jmohos/Wiper_Motor_Servo/Hardware/Kicad/Wiper_Servo_Controller/JLCPCB/invoice.pdf

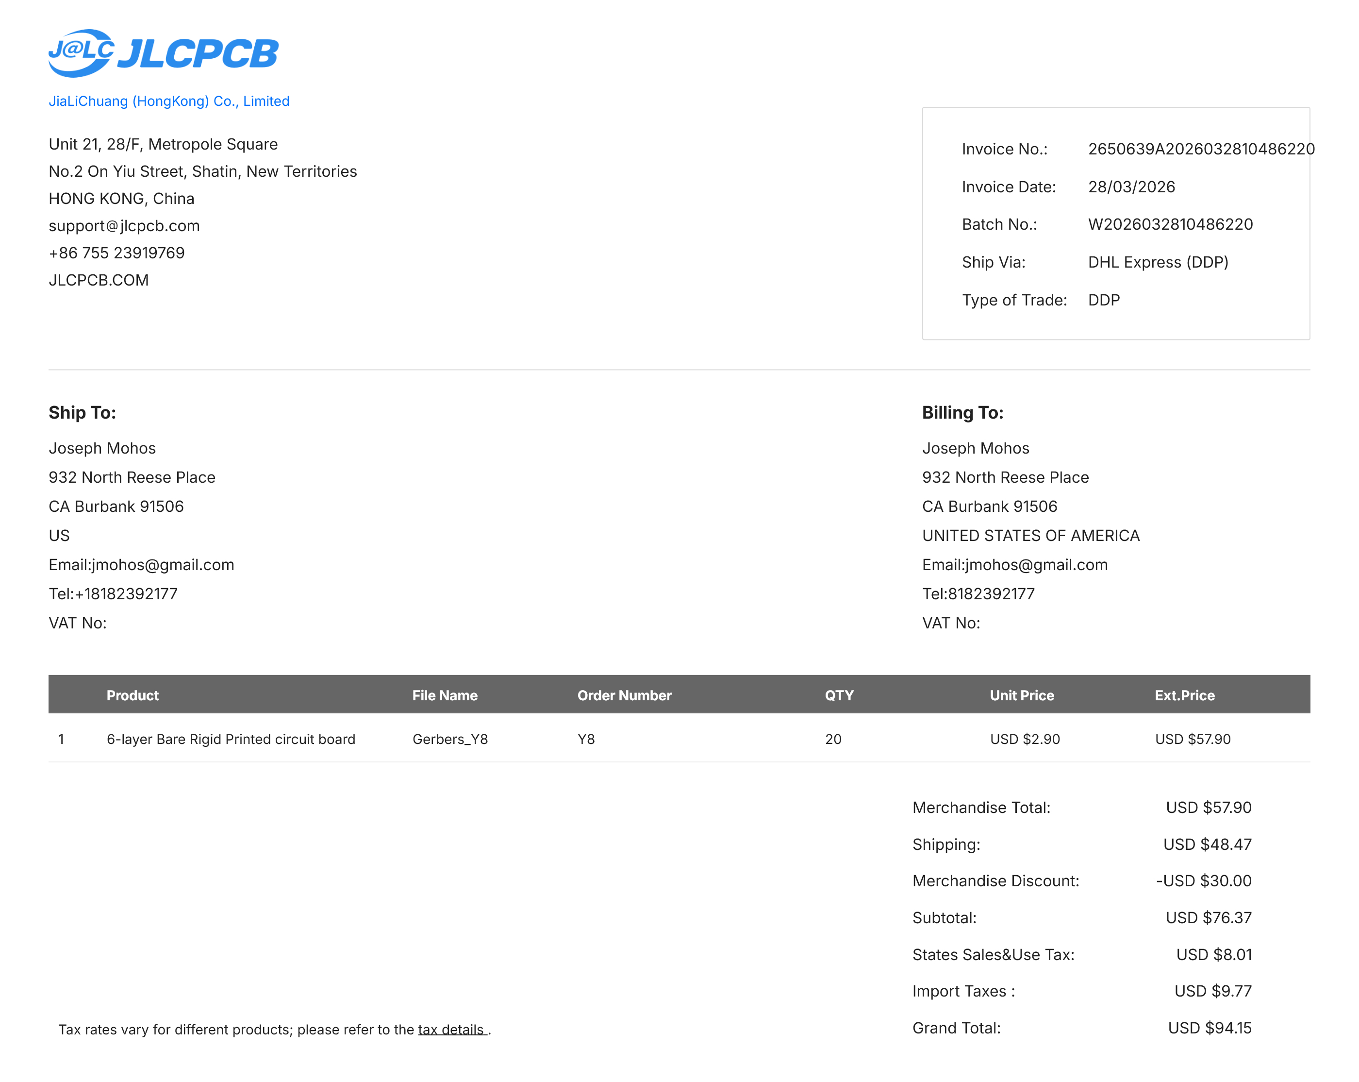
[picture p1: figure]
