jmohos/Wiper_Motor_Servo/Hardware/3D_Models/Display_Mount.stl

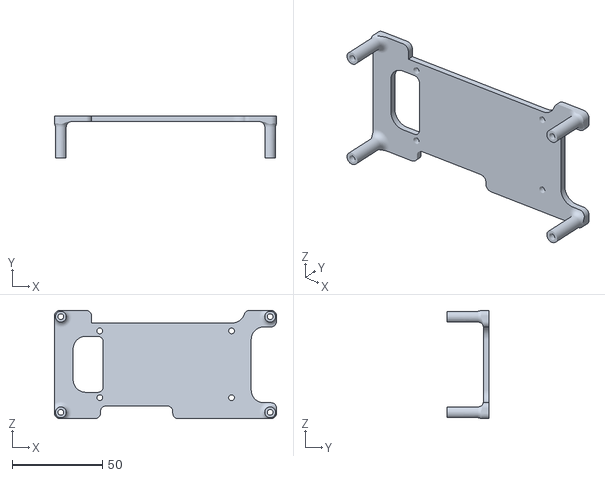
[picture p2: CAD file, 2026-04-15]
Hardware/3D_Models/Display_Mount.stl
123.0 x 23.0 x 60.0
