jmohos/Wiper_Motor_Servo/Hardware/Kicad/Wiper_Servo_Controller/RFB-0505S/RFB-0505S.step

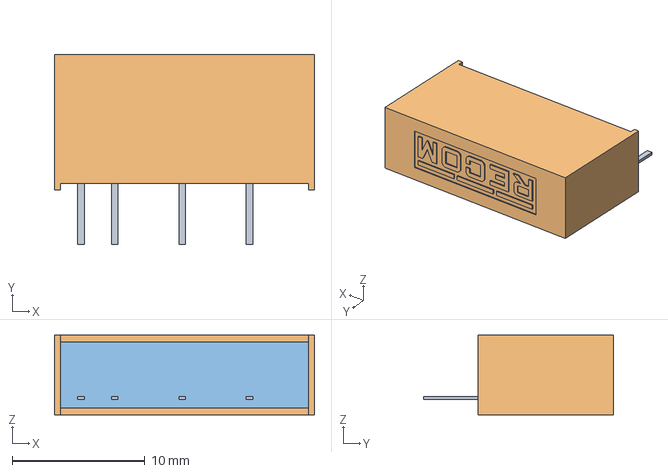
[picture p3: CAD file, 2026-03-24]
Hardware/Kicad/Wiper_Servo_Controller/RFB-0505S/RFB-0505S.step
19.6 x 14.3 x 6.00 mm
