jmohos/Wiper_Motor_Servo/Hardware/Kicad/Wiper_Servo_Controller/Wiper_Servo_Controller.step

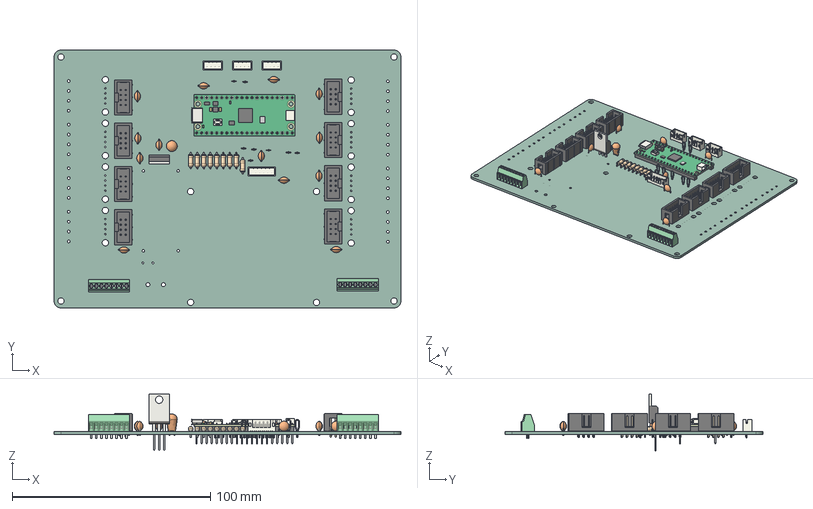
[picture p4: CAD file, 2026-04-01]
Hardware/Kicad/Wiper_Servo_Controller/Wiper_Servo_Controller.step
175.0 x 130.0 x 28.5 mm
R_Axial_DIN0207_L6.3mm_D2.5mm_P7.62mm_Horizontal x 9
TestPoint_Loop_D2.50mm_Drill1.0mm x 8
IDC-Header_2x04_P2.54mm_Vertical x 8
C_Disc_D5.1mm_W3.2mm_P5.00mm x 13
JST_PH_B4B-PH-K_1x04_P2.00mm_Vertical x 3
TerminalBlock_Phoenix_MPT-0,5-8-2.54_1x08_P2.54mm_Horizontal x 2
JST_PH_B6B-PH-K_1x06_P2.00mm_Vertical
TO-220-3_Vertical
CP_Radial_Tantal_D5.5mm_P2.50mm
RaspberryPi_Pico_H_Module_KiCad
RaspberryPi_Pico_Header_DIP-40_H2.54mm_KiCad
Wiper_Servo_Controller_PCB
