jmohos/Wiper_Motor_Servo/Hardware/3D_Models/Quad_Controller_Lower_Plate.stl

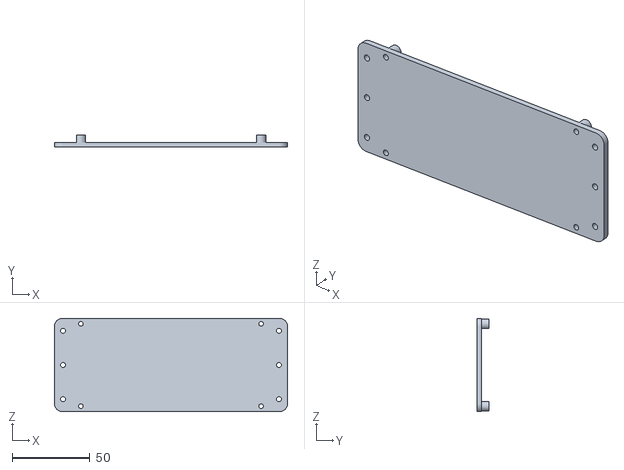
[picture p5: CAD file, 2026-04-15]
Hardware/3D_Models/Quad_Controller_Lower_Plate.stl
150.0 x 8.00 x 60.0
