jmohos/Wiper_Motor_Servo/Hardware/3D_Models/Magnet_Mount.stl

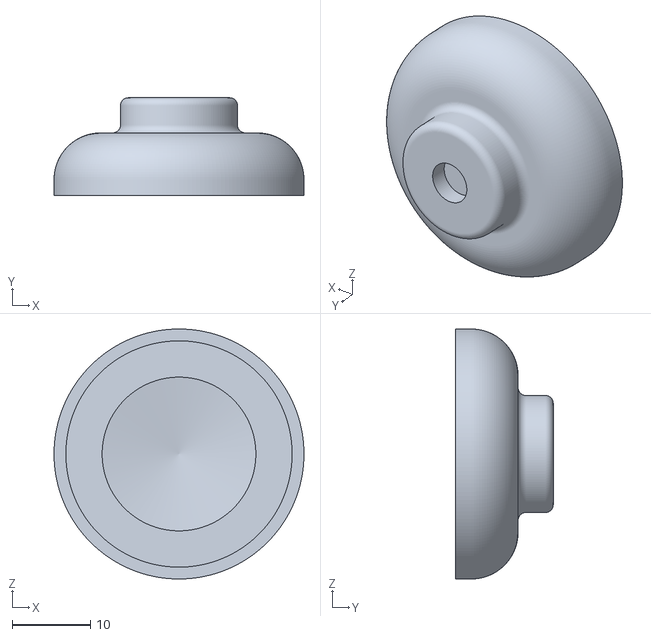
[picture p6: CAD file, 2026-03-24]
Hardware/3D_Models/Magnet_Mount.stl
32.0 x 12.5 x 32.0
