jmohos/Wiper_Motor_Servo/Hardware/3D_Models/Encoder_Cap.stl

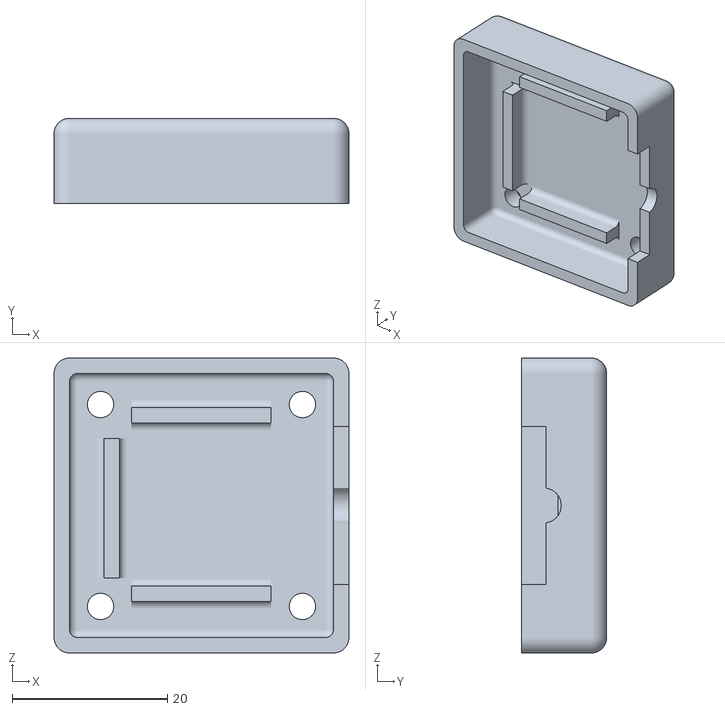
[picture p7: CAD file, 2026-03-24]
Hardware/3D_Models/Encoder_Cap.stl
38.0 x 11.0 x 38.0
