jmohos/Wiper_Motor_Servo/Hardware/3D_Models/Encoder_Plate.stl

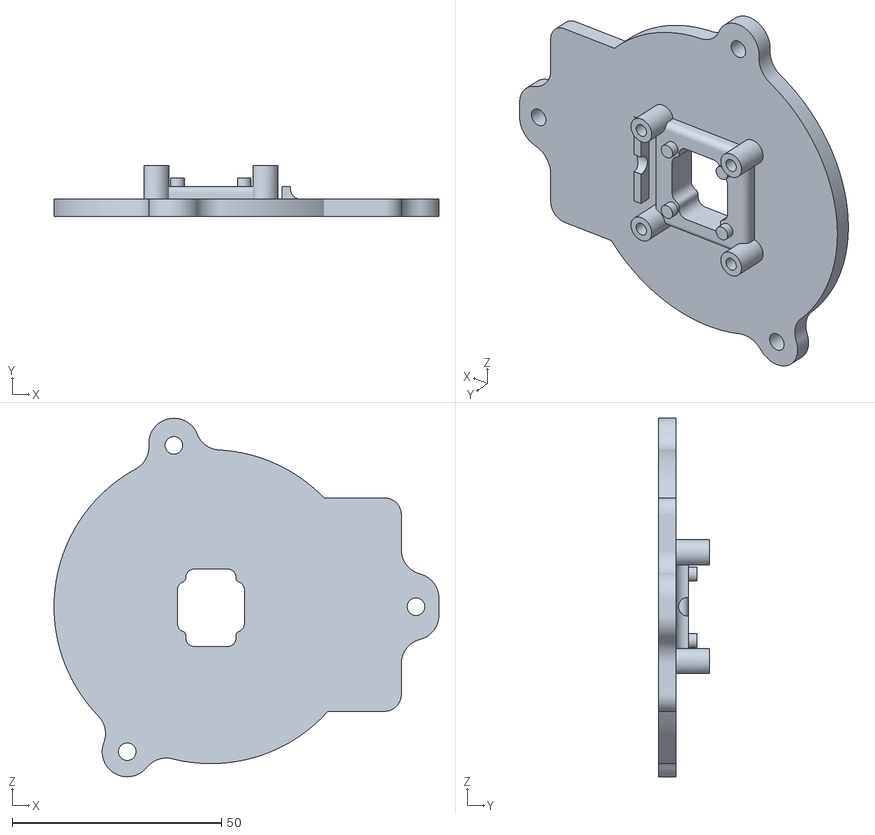
[picture p8: CAD file, 2026-03-24]
Hardware/3D_Models/Encoder_Plate.stl
92.0 x 12.1 x 85.7
