jmohos/Wiper_Motor_Servo/Hardware/Kicad/Wiper_Servo_Controller/Wiper_Servo_Controller.pdf

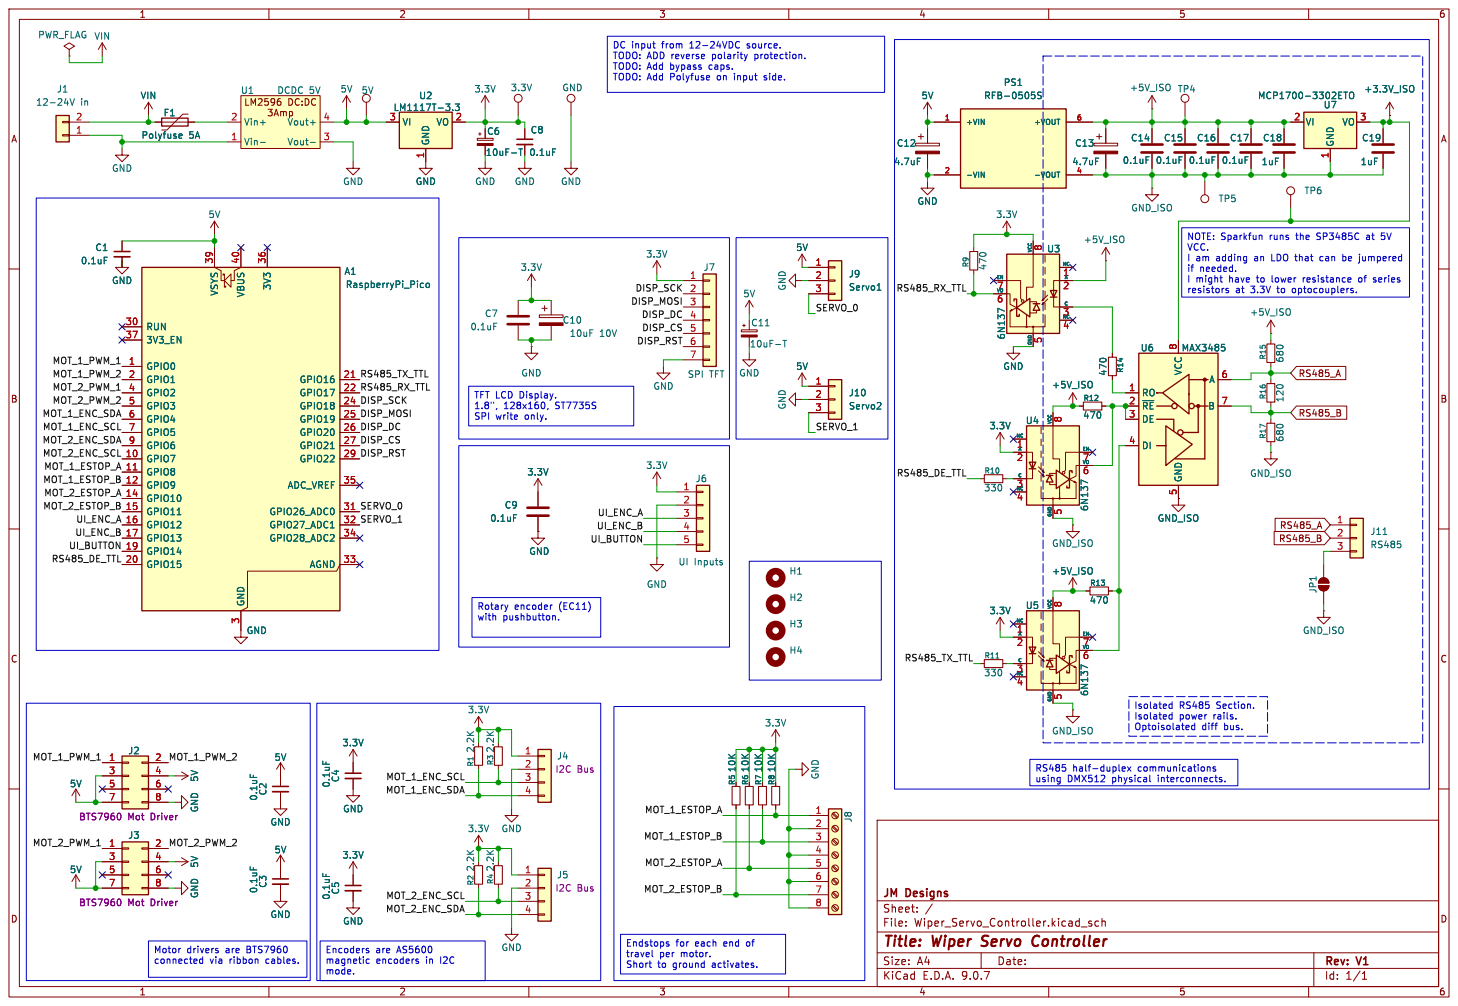
[picture p9: page 1]

VCC.
I am adding an LDO that can be jumpered
if needed.

SPI write only. Motor drivers are BTS7960

travel per motor. Short to ground activates.
