jmohos/Wiper_Motor_Servo/Hardware/Kicad/Wiper_Servo_Controller/Wiper_Servo_Controller.kicad_pcb

## KiCad design Hardware/Kicad/Wiper_Servo_Controller/Wiper_Servo_Controller.kicad_pcb (2026-04-01)

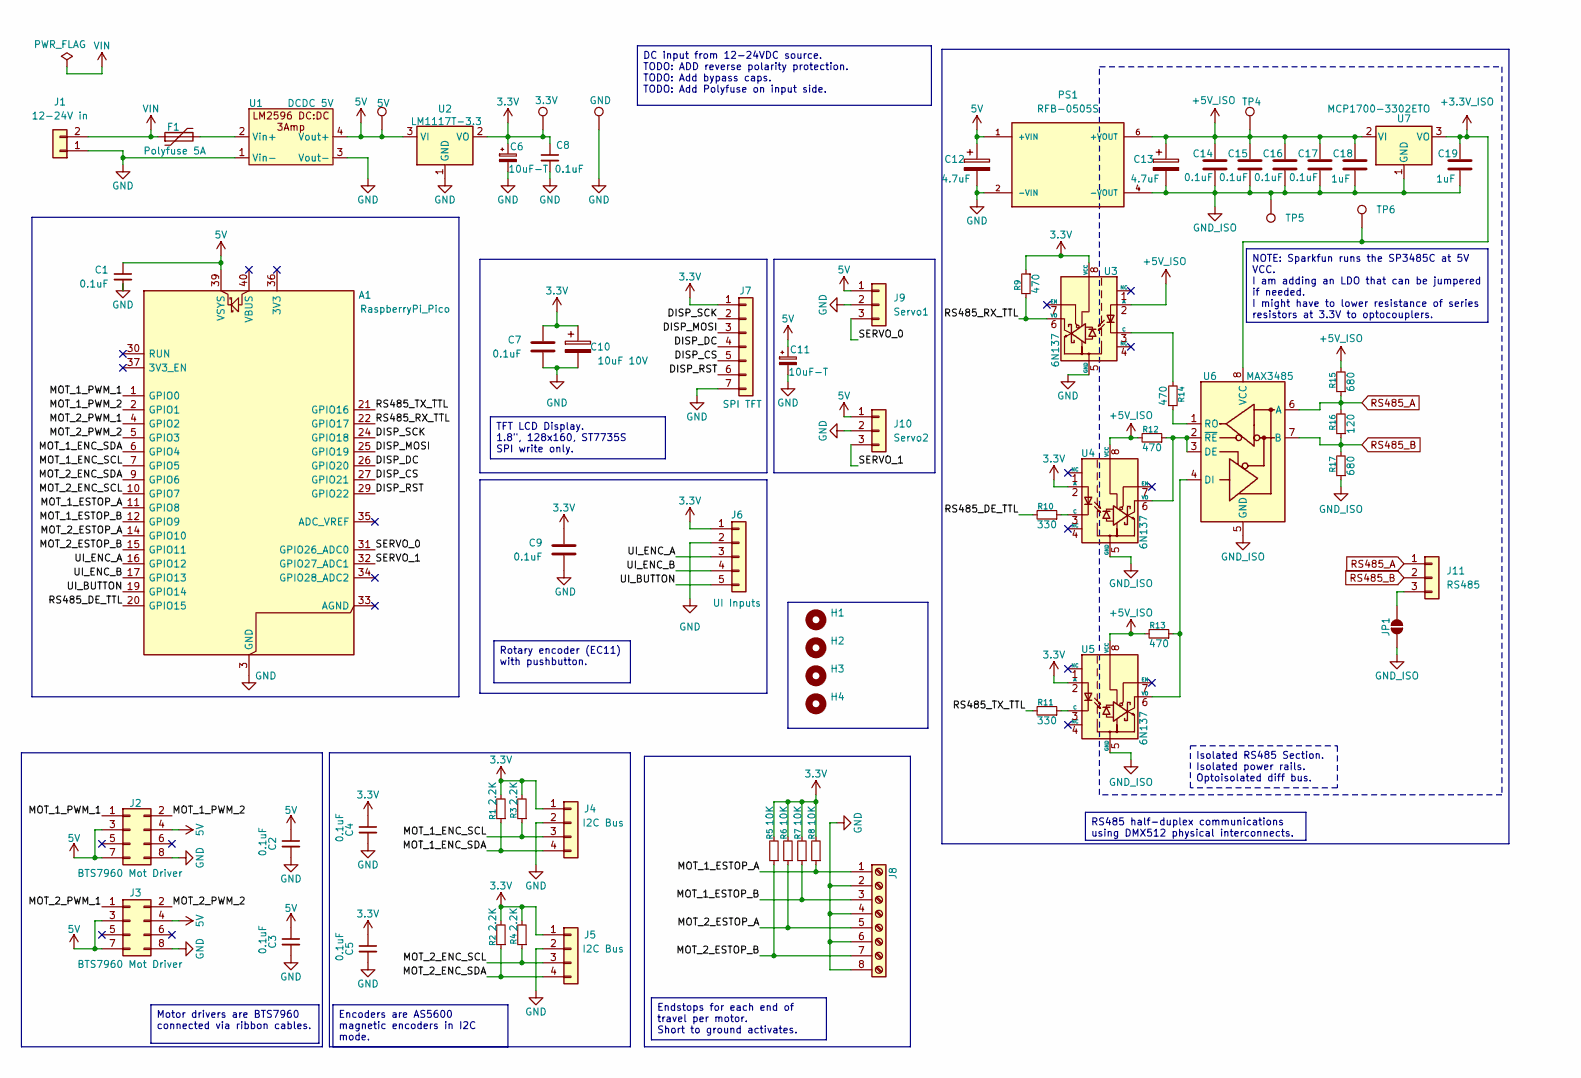
[picture p10: schematic Wiper_Servo_Controller.kicad_sch, Wiper Servo Controller, part in row 1, column 1]

Parts:
A1: RaspberryPi_Pico; RaspberryPi_Pico_Common_THT
C1, C2, C3, C4, C5, C7, C8, C9, C14, C15, C16, C17: 0.1uF; C_Disc_D5.1mm_W3.2mm_P5.00mm
C6, C11: 10uF-T; CP_Radial_Tantal_D5.5mm_P2.50mm
C10: 10uF 10V; CP_Radial_D5.0mm_P2.00mm
C12, C13: 4.7uF; CP_Radial_D5.0mm_P2.00mm
C18, C19: 1uF; C_Disc_D5.1mm_W3.2mm_P5.00mm
F1: Polyfuse 5A; Fuse_Littelfuse_395Series
H1, H2, H3, H4: MountingHole; MountingHole_3.2mm_M3
J1: 12-24V in; SolderWire-2sqmm_1x02_P7.8mm_D2mm_OD3.9mm
J2, J3: Conn_02x04_Odd_Even; IDC-Header_2x04_P2.54mm_Vertical
J4: Mot 1 Enc; JST_PH_B4B-PH-K_1x04_P2.00mm_Vertical
J5: Mot 2 Enc; JST_PH_B4B-PH-K_1x04_P2.00mm_Vertical
J6: UI Inputs; JST_PH_B5B-PH-K_1x05_P2.00mm_Vertical
J7: SPI TFT; JST_PH_B7B-PH-K_1x07_P2.00mm_Vertical
J8: Screw_Terminal_01x08; TerminalBlock_Phoenix_MPT-0,5-8-2.54_1x08_P2.54mm_Horizontal
J9: Servo1; JST_PH_B3B-PH-K_1x03_P2.00mm_Vertical
J10: Servo2; JST_PH_B3B-PH-K_1x03_P2.00mm_Vertical
J11: RS485; JST_PH_B3B-PH-K_1x03_P2.00mm_Vertical
JP1: Shield; SolderJumper-2_P1.3mm_Open_Pad1.0x1.5mm
PS1: RFB-0505S; CONV_RFB-0505S; PARTREV 1
R1, R2, R3, R4: 2.2K; R_Axial_DIN0207_L6.3mm_D2.5mm_P7.62mm_Horizontal
R5, R6, R7, R8: 10K; R_Axial_DIN0207_L6.3mm_D2.5mm_P7.62mm_Horizontal
R9, R12, R13, R14: 470; R_Axial_DIN0207_L6.3mm_D2.5mm_P7.62mm_Horizontal
R10, R11: 330; R_Axial_DIN0207_L6.3mm_D2.5mm_P7.62mm_Horizontal
R15, R17: 680; R_Axial_DIN0207_L6.3mm_D2.5mm_P7.62mm_Horizontal
R16: 120; R_Axial_DIN0207_L6.3mm_D2.5mm_P7.62mm_Horizontal
TP1: 5V; TestPoint_THTPad_D1.5mm_Drill0.7mm
TP2: 3.3V; TestPoint_THTPad_D1.5mm_Drill0.7mm
TP3: GND; TestPoint_THTPad_D1.5mm_Drill0.7mm
TP4: DMX_RX; TestPoint_THTPad_D1.5mm_Drill0.7mm
TP5: DMX_TX; TestPoint_THTPad_D1.5mm_Drill0.7mm
TP6: TestPoint_THTPad_D1.5mm_Drill0.7mm
U1: DCDC 5V; DCDC_Converter_LM2596_3A
U2: LM1117T-3.3; TO-220-3_Vertical
U3, U4, U5: 6N137; SMDIP-8_W9.53mm
U6: MAX3485; SOIC-8_3.9x4.9mm_P1.27mm
U7: MCP1700-3302ETO; TO-92_Inline

Connections:
3.3V: C4.1, C5.1, C6.1, C7.1, C8.1, C9.1, C10.1, J4.1, J5.1, J6.1, J7.1, R1.2, R2.2, R3.2, R4.2, R5.2, R6.2, R7.2, R8.2, R9.1, TP2.1, U2.2 (VO), U3.8 (VCC), U4.2 (A), U5.2 (A)
5V: A1.39 (VSYS), C1.1, C2.1, C3.1, C11.1, C12.1, J2.3, J2.4, J2.7, J3.3, J3.4, J3.7, J9.1, J10.1, PS1.1 (+VIN), TP1.1, U1.4 (Vout+), U2.3 (VI)
+3.3V_ISO: C19.1, TP6.1, U6.8 (VCC), U7.3 (VO)
+5V_ISO: C13.1, C14.1, C15.1, C16.1, C17.1, C18.1, PS1.6 (+VOUT), R12.2, R13.2, R15.2, TP4.1, U3.2 (A), U4.8 (VCC), U5.8 (VCC), U7.2 (VI)
/DISP_CS: A1.27 (GPIO21), J7.5
/DISP_DC: A1.26 (GPIO20), J7.4
/DISP_MOSI: A1.25 (GPIO19), J7.3
/DISP_RST: A1.29 (GPIO22), J7.6
/DISP_SCK: A1.24 (GPIO18), J7.2
/MOT_1_ENC_SCL: A1.7 (GPIO5), J4.3, R3.1
/MOT_1_ENC_SDA: A1.6 (GPIO4), J4.4, R1.1
/MOT_1_ESTOP_A: A1.11 (GPIO8), J8.1, R8.1
/MOT_1_ESTOP_B: A1.12 (GPIO9), J8.3, R7.1
/MOT_1_PWM_1: A1.1 (GPIO0), J2.1
/MOT_1_PWM_2: A1.2 (GPIO1), J2.2
/MOT_2_ENC_SCL: A1.10 (GPIO7), J5.3, R4.1
/MOT_2_ENC_SDA: A1.9 (GPIO6), J5.4, R2.1
/MOT_2_ESTOP_A: A1.14 (GPIO10), J8.5, R6.1
/MOT_2_ESTOP_B: A1.15 (GPIO11), J8.7, R5.1
/MOT_2_PWM_1: A1.4 (GPIO2), J3.1
/MOT_2_PWM_2: A1.5 (GPIO3), J3.2
/RS485_DE_TTL: A1.20 (GPIO15), R10.2
/RS485_RX_TTL: A1.22 (GPIO17), R9.2, U3.6 (VO)
/RS485_TX_TTL: A1.21 (GPIO16), R11.2
/SERVO_0: A1.31 (GPIO26_ADC0), J9.3
/SERVO_1: A1.32 (GPIO27_ADC1), J10.3
/UI_BUTTON: A1.19 (GPIO14), J6.5
/UI_ENC_A: A1.16 (GPIO12), J6.3
/UI_ENC_B: A1.17 (GPIO13), J6.4
GND: A1.3 (GND), A1.8 (GND), A1.13 (GND), A1.18 (GND), A1.23 (GND), A1.28 (GND), A1.38 (GND), C1.2, C2.2, C3.2, C4.2, C5.2, C6.2, C7.2, C8.2, C9.2, C10.2, C11.2, C12.2, J1.1, J2.8, J3.8, J4.2, J5.2, J6.2, J7.7, J8.2, J8.4, J8.6, J8.8, J9.2, J10.2, PS1.2 (-VIN), TP3.1, U1.1 (Vin-), U1.3 (Vout-), U2.1 (GND), U3.5 (GND)
GND_ISO: C13.2, C14.2, C15.2, C16.2, C17.2, C18.2, C19.2, JP1.1 (A), PS1.4 (-VOUT), R17.1, TP5.1, U4.5 (GND), U5.5 (GND), U6.5 (GND), U7.1 (GND)
unnamed: J11.3, JP1.2 (B)
unnamed: F1.2, U1.2 (Vin+)
unnamed: R14.2, U3.3 (C)
unnamed: R10.1, U4.3 (C)
unnamed: R12.1, U4.6 (VO), U6.2 (~RE), U6.3 (DE)
unnamed: R11.1, U5.3 (C)
unnamed: R13.1, U5.6 (VO), U6.4 (DI)
unnamed: R14.1, U6.1 (RO)
RS485_A: J11.1, R15.1, R16.2, U6.6 (A)
RS485_B: J11.2, R16.1, R17.2, U6.7 (B)
VIN: F1.1, J1.2

Notes on the sheet:
RS485 half-duplex communications using DMX512 physical interconnects.
Motor drivers are BTS7960 connected via ribbon cables.
TFT LCD Display. 1.8", 128x160, ST7735S SPI write only.
Isolated RS485 Section. Isolated power rails. Optoisolated diff bus.
DC input from 12-24VDC source. TODO: ADD reverse polarity protection. TODO: Add bypass caps. TODO: Add Polyfuse on input side.
NOTE: Sparkfun runs the SP3485C at 5V VCC. I am adding an LDO that can be jumpered if needed. I might have to lower resistance of series resistors at 3.3V to optocouplers.
Rotary encoder (EC11) with pushbutton.
Endstops for each end of travel per motor. Short to ground activates.
Encoders are AS5600 magnetic encoders in I2C mode.

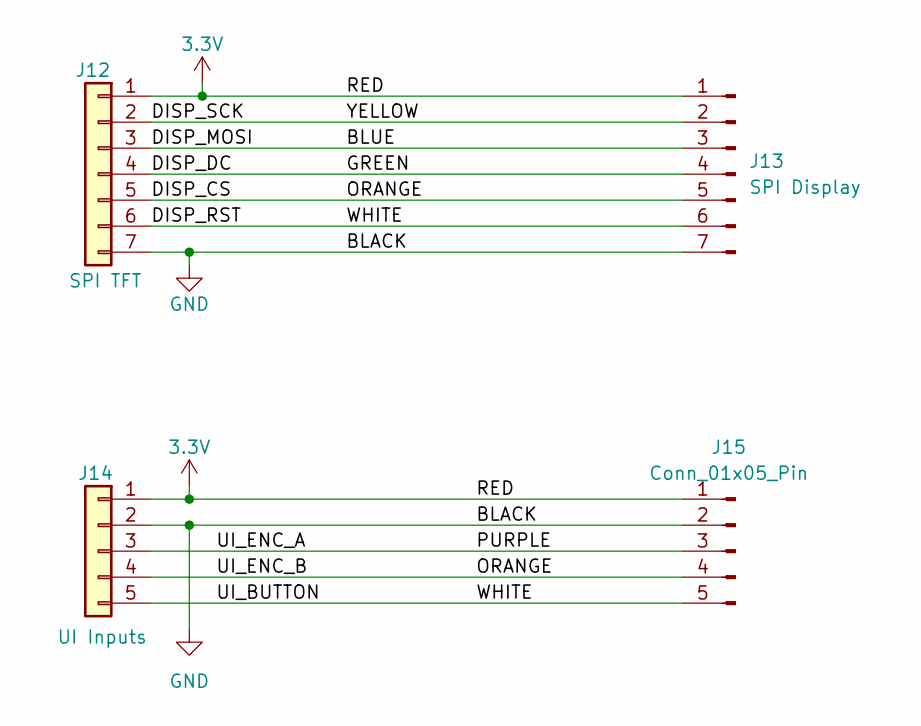
[picture p11: schematic cable_diagrams.kicad_sch]

Parts:
J12: SPI TFT; JST_PH_B7B-PH-K_1x07_P2.00mm_Vertical
J13: SPI Display
J14: UI Inputs; JST_PH_B5B-PH-K_1x05_P2.00mm_Vertical
J15: Conn_01x05_Pin

Connections:
unnamed: J12.1, J13.1, J14.1, J15.1
unnamed: J12.2, J13.2
unnamed: J12.3, J13.3
unnamed: J12.4, J13.4
unnamed: J12.5, J13.5, J14.4, J15.4
unnamed: J12.6, J13.6, J14.5, J15.5
unnamed: J12.7, J13.7, J14.2, J15.2
unnamed: J14.3, J15.3

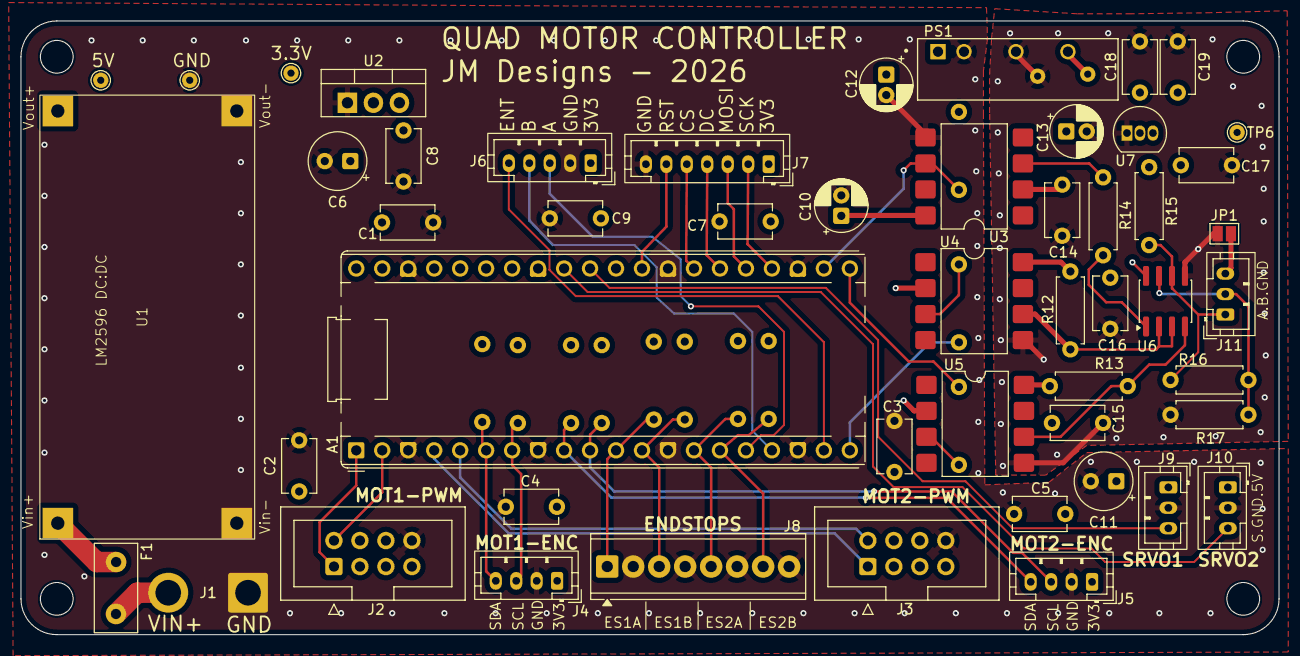
[picture p12: board Wiper_Servo_Controller.kicad_pcb from above]

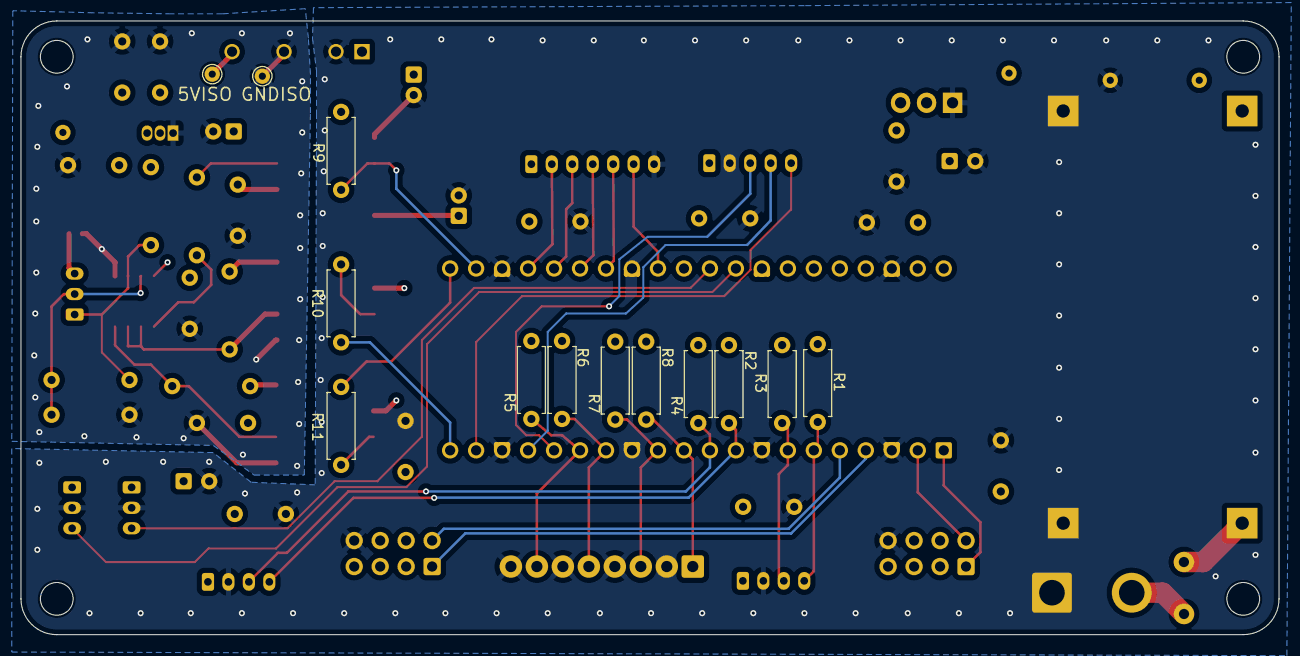
[picture p13: board Wiper_Servo_Controller.kicad_pcb from below]

Board: 6 copper layers, 123.0 x 60.0 mm, 68 parts (13 on the bottom side), 42 nets.
