jmohos/Wiper_Motor_Servo/Software/Wiper_Servo_Motor/src/main.cpp

/*
  RP2040 Dual Brushless Wiper Motor Controller
  =============================================
  Closed-loop motor controller for two brushless windshield wiper motors.

  Hardware:
    Motor 0 driver : BTS7960 — IN1=GPIO0, IN2=GPIO1  (25 kHz PWM, slice 0)
    Motor 1 driver : BTS7960 — IN1=GPIO2, IN2=GPIO3  (25 kHz PWM, slice 1)
    Motor 0 encoder: AS5600  — SDA=GPIO4, SCL=GPIO5  (I2C0 master)
    Motor 1 encoder: AS5600  — SDA=GPIO6, SCL=GPIO7  (I2C1 master)
    Endstops       : Motor 0 A/B = GPIO8/9, Motor 1 A/B = GPIO10/11
    Local UI       : Encoder CLK=GPIO12, DT=GPIO13, SW=GPIO14
                     SPI OLED SCK=GPIO18, MOSI=GPIO19, DC=GPIO20,
                               CS=GPIO21, RST=GPIO22

  Note: The former I2C slave interface (GPIO26/27) has been retired.
        Local control is now provided by the OLED + rotary encoder.

  Control modes (per motor):
    MANUAL   — raw speed (0–255) drives PWM directly
    VELOCITY — velocity PID regulates angular velocity (deg/sec)
    POSITION — cascade: position PID → velocity setpoint → velocity PID → PWM

  Core assignment:
    Core 0 — control loop (50 Hz), console input (non-blocking reads only)
    Core 1 — status print (2 Hz)
             Serial output is entirely on Core 1 so it cannot stall Core 0.

  USB Serial console commands  (m = motor index: 0 or 1):
    v  <m> <n>         Velocity mode — target in deg/sec (+CW, −CCW)
    va <m> <n>         Velocity accel limit in deg/s² (default 200)
    p  <m> <n>         Position mode — target angle in degrees
    p  <m> <n> <vel>   Position mode with explicit traverse velocity
    pv <m> <n>         Position traverse velocity in deg/s (default 90)
    pmode <m> <0|1>    Position path: 0=shortest arc, 1=constrained (default)
    plim <m> <lo> <hi> Constrained travel limits in degrees (default 0 355)
    r  <m> <n>         Manual mode — raw PWM 0–255 (127=coast)
    stop <m>           Coast motor m, enter MANUAL mode
    stop               Coast all motors
    gains              Print all PID gains
    gains <m>          Print gains for motor m only
    kp  <m> <n>        Velocity PID Kp
    ki  <m> <n>        Velocity PID Ki (also resets integrator)
    kd  <m> <n>        Velocity PID Kd
    pkp <m> <n>        Position PID Kp
    pki <m> <n>        Position PID Ki (also resets integrator)
    pkd <m> <n>        Position PID Kd
    zero <m>           Set current position as mechanical zero (RAM only)
    servo  <s> <n>     RC servo s (0 or 1) — target angle 0–180°
    servor <s> <n>     RC servo s ramp rate in deg/s (default 90)
    freeze             Stop logging, coast all motors, dump CSV to console
    resume             Clear buffer, restart logging
    save               Write motor 0 settings/cal to non-volatile flash
    load               Reload settings from flash (applied to all motors)
    defaults           Reset all settings to factory defaults (RAM only)
*/

#include <Arduino.h>
#include "Config.h"
#include "MotorPWM.h"
#include "I2CSlave.h"       // retained for in-memory state; begin() not called
#include "AS5600.h"
#include "EndstopMonitor.h"
#include "LocalUI.h"
#include "PIDController.h"
#include "MotorControlProtocol.h"
#include "DataLogger.h"
#include "Settings.h"
#include <Servo.h>
#include "Display.h"
#include "AnimComSlave.h"
#include "StationAnim.h"

// AnimCom RS485 slave
static AnimComSlave g_animcom;

// AnimCom global control state — written by callbacks, read by controlLoop().
static volatile uint8_t  g_animState      = ANIMCOM_STATE_STOP;
static volatile uint8_t  g_animPattern    = 0;
static volatile uint8_t  g_animShowIntensity = 100;

// Timestamp of the last MANUAL_SINGLE command per motor channel.
// Used to detect ManualHold (keepalives arrive but no channel commands).
// Initialised to 0; controlLoop() coasts the motor if the gap exceeds the threshold.
static constexpr uint32_t MANUAL_CMD_TIMEOUT_MS = 400;  // ~2 missed frames at typical rate
static volatile uint32_t  g_lastManualCmdMs[NUM_MOTORS] = {0, 0};

// ---------------------------------------------------------------------------
// Top-level UI state machine
//   g_inMenu   — true while the user is navigating the mode-selection menu
//   g_menuSel  — currently highlighted menu item (0–NUM_APP_STATES-1)
//   g_appState — the active AppState when not in the menu
// Both Core 0 (writes via encoder ISR consumer) and Core 1 (reads for display)
// access these.  They are uint8_t / bool so reads/writes are atomic on RP2040.
// ---------------------------------------------------------------------------
static volatile bool     g_inMenu   = false;           // start directly in ANIMCOM, not menu
static volatile uint8_t  g_menuSel  = STATE_ANIMCOM;   // menu cursor pre-positioned on ANIMCOM
static volatile AppState g_appState = STATE_ANIMCOM;   // default startup state

// Config screen navigation — Core 0 writes, Core 1 reads for display.
// CFG_* indices mirror kLabels[] in Display.cpp; keep in sync.
enum CfgItem : uint8_t {
    CFG_NODE_ID    = 0,
    CFG_M0_TYPE    = 1,
    CFG_M0_VELLIM  = 2,
    CFG_M0_TRAVVEL = 3,
    CFG_M1_TYPE    = 4,
    CFG_M1_VELLIM  = 5,
    CFG_M1_TRAVVEL = 6,
    CFG_SAVE       = 7,
    CFG_EXIT       = 8,
};
static volatile uint8_t g_cfgSel  = 0;      // selected config item
static volatile bool    g_cfgEdit = false;   // true while encoder is editing

// MANUAL mode cursor.
// g_manualSel: 0=M0, 1=M1, 2=S0, 3=S1, 4=EXIT  (cursor position in scroll mode)
// g_manualEdit: true while encoder is adjusting the selected motor/servo setpoint.
static constexpr uint8_t MANUAL_NUM_ITEMS = 5;   // M0, M1, S0, S1, EXIT
static constexpr uint8_t MANUAL_EXIT_IDX  = 4;
static volatile uint8_t  g_manualSel  = 0;
static volatile bool     g_manualEdit = false;

// RC servo instances — attached in setup(); driven by controlLoop() ramp.
static Servo g_servo[NUM_SERVOS];
// Per-servo ramp state — written by Core 0 controlLoop(), read by Core 1 display.
static volatile float g_servoTarget  [NUM_SERVOS] = {90.0f, 90.0f}; // commanded target (deg)
static volatile float g_servoActual  [NUM_SERVOS] = {90.0f, 90.0f}; // current ramped output (deg)
static volatile float g_servoRampRate[NUM_SERVOS] = {90.0f, 90.0f}; // ramp rate (deg/s)

// One encoder instance per I2C bus — both sensors share address 0x36 but
// are isolated on separate buses so they coexist without conflict.
static AS5600 g_enc0(Wire);   // Motor 0 — I2C0 (GPIO4/5)
static AS5600 g_enc1(Wire1);  // Motor 1 — I2C1 (GPIO6/7)

// ---------------------------------------------------------------------------
// Per-motor control state
// All volatile so Core 1 can safely read for status printing.
// 32-bit aligned reads/writes are atomic on Cortex-M0+.
// ---------------------------------------------------------------------------
enum ControlMode  : uint8_t { MANUAL = 0, VELOCITY = 1, POSITION = 2 };
enum PosPathMode  : uint8_t { POS_PATH_SHORTEST = 0, POS_PATH_CONSTRAINED = 1 };

static volatile ControlMode g_mode        [NUM_MOTORS] = {MANUAL,              MANUAL};
static volatile float       g_targetVel   [NUM_MOTORS] = {0.0f,                0.0f};
static volatile float       g_commandedVel[NUM_MOTORS] = {0.0f,                0.0f};
static volatile float       g_velAccel    [NUM_MOTORS] = {200.0f,              200.0f};
static volatile float       g_targetPos   [NUM_MOTORS] = {0.0f,                0.0f};
static volatile float       g_commandedPos[NUM_MOTORS] = {0.0f,                0.0f};
static volatile float       g_traverseVel [NUM_MOTORS] = {90.0f,               90.0f};
static volatile PosPathMode g_posPathMode [NUM_MOTORS] = {POS_PATH_CONSTRAINED, POS_PATH_CONSTRAINED};
static volatile float       g_posMin      [NUM_MOTORS] = {0.0f,                0.0f};
static volatile float       g_posMax      [NUM_MOTORS] = {355.0f,              355.0f};
static volatile float       g_zeroOffset  [NUM_MOTORS] = {0.0f,                0.0f};
static volatile uint16_t    g_lastRawAngle[NUM_MOTORS] = {0,                   0};
static volatile float       g_measVel     [NUM_MOTORS] = {0.0f,                0.0f};
static volatile float       g_measPos     [NUM_MOTORS] = {0.0f,                0.0f};
static volatile float       g_pidOutput   [NUM_MOTORS] = {0.0f,                0.0f};
static volatile float       g_posError    [NUM_MOTORS] = {0.0f,                0.0f};
static volatile float       g_measPosAbs  [NUM_MOTORS] = {0.0f,                0.0f};  // accumulated multi-turn (deg)
static volatile bool        g_encoderOffline[NUM_MOTORS] = {false,             false}; // true when AS5600 returns 0xFFFF
static volatile bool        g_streamEnabled  = true;    // serial status stream on/off

static void applyAnimRunPattern(uint32_t nowMs)
{
    if (g_inMenu || g_appState != STATE_ANIMCOM) return;  // only active in ANIMCOM state
    if (g_animState != ANIMCOM_STATE_RUN_AUTO) return;

    // Station-specific animation takes priority over generic patterns.
    // Each nodeId with a registered handler gets its own motion behaviour
    // instead of the generic sine-wave patterns below.
    if (stationAnim_hasHandler(Settings::s.nodeId)) {
        // Initialise outputs from current state; the handler only writes the
        // channels it owns so uncontrolled motors/servos are left unchanged.
        float   posMin[NUM_MOTORS], posMax[NUM_MOTORS];
        uint8_t outMode[NUM_MOTORS];
        float   outTargetPos[NUM_MOTORS], outTargetVel[NUM_MOTORS];
        float   outServoTarget[NUM_SERVOS];

        for (uint8_t m = 0; m < NUM_MOTORS; m++) {
            posMin[m]       = Settings::s.motor[m].posMin;
            posMax[m]       = Settings::s.motor[m].posMax;
            outMode[m]      = (uint8_t)g_mode[m];
            outTargetPos[m] = g_targetPos[m];
            // In POSITION mode outTargetVel carries traverse velocity;
            // in VELOCITY/MANUAL mode it carries the velocity setpoint.
            outTargetVel[m] = (g_mode[m] == POSITION) ? g_traverseVel[m] : g_targetVel[m];
        }
        for (uint8_t s = 0; s < NUM_SERVOS; s++) outServoTarget[s] = g_servoTarget[s];

        stationAnim_update(Settings::s.nodeId, nowMs, g_animShowIntensity,
                           posMin, posMax,
                           outMode, outTargetPos, outTargetVel, outServoTarget);

        for (uint8_t m = 0; m < NUM_MOTORS; m++) {
            g_mode[m]      = (ControlMode)outMode[m];
            g_targetPos[m] = outTargetPos[m];
            // Apply outTargetVel back to the correct variable for the output mode.
            // A zero value means the handler left it unchanged — skip the write.
            if (outTargetVel[m] > 0.0f) {
                if ((ControlMode)outMode[m] == POSITION)
                    g_traverseVel[m] = outTargetVel[m];
                else
                    g_targetVel[m] = outTargetVel[m];
            }
        }
        for (uint8_t s = 0; s < NUM_SERVOS; s++) g_servoTarget[s] = outServoTarget[s];
        return;
    }

    // Generic patterns — used by units without a dedicated station handler.
    if (g_animShowIntensity == 0) return;

    const float intensityFactor = (float)g_animShowIntensity / 100.0f;
    const float theta = ((float)nowMs * intensityFactor) * (2.0f * PI / 6000.0f);
    const float sin0 = sinf(theta);
    const float sin1 = sinf(theta + (PI * 0.5f));

    switch (g_animPattern) {
    case 2:
        g_mode[0] = POSITION;
        g_mode[1] = POSITION;
        g_targetPos[0] = 90.0f + 70.0f * sin0;
        g_targetPos[1] = 180.0f + 120.0f * sin1;
        g_servoTarget[0] = constrain(90.0f + 45.0f * sin1, 0.0f, 180.0f);
        g_servoTarget[1] = constrain(90.0f - 45.0f * sin0, 0.0f, 180.0f);
        break;

    case 3:
        g_mode[0] = VELOCITY;
        g_mode[1] = POSITION;
        g_targetVel[0] = (sin0 >= 0.0f) ? 240.0f : -240.0f;
        g_targetPos[1] = 180.0f + 140.0f * sin0;
        g_servoTarget[0] = constrain(90.0f + 60.0f * sin1, 0.0f, 180.0f);
        g_servoTarget[1] = constrain(90.0f + 75.0f * sin0, 0.0f, 180.0f);
        break;

    case 0:
    case 1:
    default:
        g_mode[0] = VELOCITY;
        g_mode[1] = VELOCITY;
        g_targetVel[0] = 180.0f * sin0;
        g_targetVel[1] = 120.0f * sin1;
        g_servoTarget[0] = constrain(90.0f + 60.0f * sin0, 0.0f, 180.0f);
        g_servoTarget[1] = constrain(90.0f + 60.0f * sin1, 0.0f, 180.0f);
        break;
    }
}

// ---------------------------------------------------------------------------
// PID controllers — Core 0 only, not volatile
// ---------------------------------------------------------------------------
static constexpr float POS_VEL_LIMIT = 360.0f;

static PIDController g_velPid[NUM_MOTORS] = {
    PIDController(0.8f, 0.1f, 0.0f, -127.0f,        127.0f),
    PIDController(0.8f, 0.1f, 0.0f, -127.0f,        127.0f)
};
static PIDController g_posPid[NUM_MOTORS] = {
    PIDController(3.0f, 0.0f, 0.0f, -POS_VEL_LIMIT, POS_VEL_LIMIT),
    PIDController(3.0f, 0.0f, 0.0f, -POS_VEL_LIMIT, POS_VEL_LIMIT)
};

// ---------------------------------------------------------------------------
// AnimCom callback implementations
// ---------------------------------------------------------------------------

static void onAnimControlState(uint8_t state, uint8_t pattern, uint8_t show_intensity)
{
    // Always track RS485 state for display; only act on motors in ANIMCOM mode.
    g_animState         = state;
    g_animPattern       = pattern;
    g_animShowIntensity = show_intensity;

    if (g_appState != STATE_ANIMCOM || g_inMenu) return;

    if (state == ANIMCOM_STATE_STOP) {
        for (uint8_t m = 0; m < NUM_MOTORS; m++) {
            g_mode[m] = MANUAL;
            g_velPid[m].reset();
            g_posPid[m].reset();
            MotorPWM::setMotor(m, MCP_SPEED_IDLE);
        }
        // Coast RC servos to center
        for (uint8_t s = 0; s < NUM_SERVOS; s++) g_servoTarget[s] = 90.0f;
        I2CSlave::lastCmdMs = millis();
    }
}

static void onAnimManualSingle(uint8_t ch, uint8_t cmd_type, int32_t value)
{
    if (g_appState != STATE_ANIMCOM || g_inMenu) return;
    I2CSlave::lastCmdMs = millis();

    if (ch < NUM_MOTORS) {
        g_lastManualCmdMs[ch] = millis();
        // DC closed-loop motor
        switch (cmd_type) {

        case ANIMCOM_CMD_SPEED_PERCENT: {
            // value low byte is signed percent -100..+100
            int8_t pct = (int8_t)(value & 0xFF);
            float  vel = (float)pct * 3.6f;   // rough: 100% ≈ 360 deg/s
            g_targetVel[ch] = vel;
            if (g_mode[ch] != VELOCITY) g_velPid[ch].reset();
            g_mode[ch] = VELOCITY;
            break;
        }
        case ANIMCOM_CMD_SPEED_DEG_PER_SEC: {
            int16_t dps = (int16_t)(value & 0xFFFF);
            g_targetVel[ch] = (float)dps;
            if (g_mode[ch] != VELOCITY) g_velPid[ch].reset();
            g_mode[ch] = VELOCITY;
            break;
        }
        case ANIMCOM_CMD_POSITION_DEG: {
            int16_t deg = (int16_t)(value & 0xFFFF);
            g_targetPos[ch] = (float)deg;
            if (g_mode[ch] != POSITION) {
                g_velPid[ch].reset();
                g_posPid[ch].reset();
                g_commandedPos[ch] = (float)g_measPosAbs[ch];
            }
            g_mode[ch] = POSITION;
            break;
        }
        default:
            break;
        }

    } else if (ch < NUM_MOTORS + NUM_SERVOS) {
        // RC servo (channel 2 or 3)
        uint8_t si = ch - NUM_MOTORS;   // servo index 0 or 1
        if (cmd_type == ANIMCOM_CMD_SPEED_PERCENT) {
            int8_t pct = (int8_t)(value & 0xFF);
            float deg = 90.0f + (float)pct * 0.9f;
            g_servoTarget[si] = constrain(deg, 0.0f, 180.0f);
        } else if (cmd_type == ANIMCOM_CMD_POSITION_DEG) {
            int16_t deg = (int16_t)(value & 0xFFFF);
            g_servoTarget[si] = constrain((float)deg, 0.0f, 180.0f);
        }
    }
}

static void onAnimTriggerEffect(uint8_t effect_type, uint8_t effect_id, uint16_t effect_param)
{
    // Audio playback trigger — placeholder for future DFPlayer or I2S audio module.
    if (effect_type == ANIMCOM_EFFECT_AUDIO_PLAY) {
        Serial.printf("[AnimCom] AUDIO_PLAY  track=%d  param=%d\n", effect_id, effect_param);
    }
}

static void onAnimWatchdog()
{
    if (g_appState != STATE_ANIMCOM || g_inMenu) return;
    // Watchdog fired — coast all motors and center servos.
    for (uint8_t m = 0; m < NUM_MOTORS; m++) {
        g_mode[m] = MANUAL;
        g_velPid[m].reset();
        g_posPid[m].reset();
        MotorPWM::setMotor(m, MCP_SPEED_IDLE);
    }
    for (uint8_t s = 0; s < NUM_SERVOS; s++) g_servoTarget[s] = 90.0f;

    // Stations with a dedicated handler resume their default animation rather
    // than stopping, so the prop maintains a sensible stand-alone state when
    // the animation controller is absent or the RS485 cable is disconnected.
    if (stationAnim_hasHandler(Settings::s.nodeId)) {
        g_animState      = ANIMCOM_STATE_RUN_AUTO;
        g_animPattern    = 0;
        g_animShowIntensity = stationAnim_defaultShowIntensity(Settings::s.nodeId);
    } else {
        g_animState      = ANIMCOM_STATE_STOP;
        g_animPattern    = 0;
        g_animShowIntensity = 100;
    }
}

// ---------------------------------------------------------------------------
// Motor safety helper — coast all motors and clear animcom state.
// ---------------------------------------------------------------------------
static void coastAll() {
    for (uint8_t m = 0; m < NUM_MOTORS; m++) {
        g_mode[m] = MANUAL;
        g_velPid[m].reset();
        g_posPid[m].reset();
        MotorPWM::setMotor(m, MCP_SPEED_IDLE);
    }
    g_animState = ANIMCOM_STATE_STOP;
}

// ---------------------------------------------------------------------------
// Settings helpers — NVM stores independent settings per motor.
// ---------------------------------------------------------------------------
static void applySettings() {
    // Apply RS485 node ID to the AnimCom slave parser.
    g_animcom.setNodeId(Settings::s.nodeId);

    for (uint8_t m = 0; m < NUM_MOTORS; m++) {
        const NvmSettings::MotorSettings& ms = Settings::s.motor[m];
        g_velPid[m].kp   = ms.velKp;
        g_velPid[m].ki   = ms.velKi;
        g_velPid[m].kd   = ms.velKd;
        g_velAccel[m]    = ms.velAccel;
        g_posPid[m].kp   = ms.posKp;
        g_posPid[m].ki   = ms.posKi;
        g_posPid[m].kd   = ms.posKd;
        g_traverseVel[m] = ms.traverseVel;
        g_posPathMode[m] = (PosPathMode)ms.posPathMode;
        g_posMin[m]      = ms.posMin;
        g_posMax[m]      = ms.posMax;
        g_zeroOffset[m]  = ms.zeroOffset;
        // velLimit is read directly from Settings::s.motor[m].velLimit at run time.
    }
}

static void captureSettings() {
    for (uint8_t m = 0; m < NUM_MOTORS; m++) {
        NvmSettings::MotorSettings& ms = Settings::s.motor[m];
        ms.velKp       = g_velPid[m].kp;
        ms.velKi       = g_velPid[m].ki;
        ms.velKd       = g_velPid[m].kd;
        ms.velAccel    = g_velAccel[m];
        ms.posKp       = g_posPid[m].kp;
        ms.posKi       = g_posPid[m].ki;
        ms.posKd       = g_posPid[m].kd;
        ms.traverseVel = g_traverseVel[m];
        ms.posPathMode = (uint8_t)g_posPathMode[m];
        ms.posMin      = g_posMin[m];
        ms.posMax      = g_posMax[m];
        ms.zeroOffset  = g_zeroOffset[m];
    }
}

// ---------------------------------------------------------------------------
// Core 1 — status print (2 Hz) + display refresh (5 Hz).
// All Serial output lives here so it cannot stall the Core 0 control loop.
// Display SPI is used exclusively from Core 1 after Display::begin().
// ---------------------------------------------------------------------------
void setup1() {}

void loop1() {
    static uint32_t lastSerialMs = 0;
    static uint32_t lastDispMs   = 0;
    uint32_t now = millis();

    // ---- Serial status @ 2 Hz ----------------------------------------
    if (g_streamEnabled && now - lastSerialMs >= 500) {
        lastSerialMs = now;
        for (uint8_t m = 0; m < NUM_MOTORS; m++) {
            ControlMode mode    = g_mode[m];
            float       measVel = g_measVel[m];
            float       measPos = g_measPos[m];
            float       absPos  = g_measPosAbs[m];
            float       tgtVel  = g_targetVel[m];
            float       cmdVel  = g_commandedVel[m];
            float       tgtPos  = g_targetPos[m];
            float       cmdPos  = g_commandedPos[m];
            float       travVel = g_traverseVel[m];
            float       pidOut  = g_pidOutput[m];
            float       posErr  = g_posError[m];
            int16_t     duty    = MotorPWM::rawDuty[m];

            Serial.print("M"); Serial.print(m);
            if (mode == POSITION) {
                Serial.print(" POS");
                Serial.print("  Abs:");  Serial.print(absPos,  1); Serial.print("deg");
                Serial.print("  Cmd:");  Serial.print(cmdPos,  1); Serial.print("deg");
                Serial.print("  Tgt:");  Serial.print(tgtPos,  1); Serial.print("deg");
                Serial.print("  Err:");  Serial.print(posErr,  1); Serial.print("deg");
                Serial.print("  @");     Serial.print(travVel, 1); Serial.print("deg/s");
            } else {
                Serial.print(mode == VELOCITY ? " VEL" : " MAN");
                Serial.print("  Pos:");  Serial.print(measPos, 1); Serial.print("deg");
                Serial.print("  Abs:");  Serial.print(absPos,  1); Serial.print("deg");
                Serial.print("  Vel:");  Serial.print(measVel, 1);
                Serial.print("deg/s("); Serial.print(measVel / 6.0f, 1); Serial.print("RPM)");
                if (mode == VELOCITY) {
                    Serial.print("  Cmd:"); Serial.print(cmdVel, 1); Serial.print("deg/s");
                    Serial.print("  Tgt:"); Serial.print(tgtVel, 1); Serial.print("deg/s");
                }
            }
            Serial.print("  PID:"); Serial.print(pidOut, 1);
            Serial.print("  Duty:"); Serial.println(duty);
        }
    }

    // ---- Display refresh @ 5 Hz --------------------------------------
    if (now - lastDispMs >= 200) {
        lastDispMs = now;

        if (g_inMenu) {
            Display::drawMenu(g_menuSel);
        } else if (g_appState == STATE_CONFIG) {
            ConfigDisplayState cfg;
            cfg.selectedItem  = g_cfgSel;
            cfg.editMode      = g_cfgEdit;
            cfg.nodeId        = Settings::s.nodeId;
            for (uint8_t m = 0; m < NUM_MOTORS; m++) {
                cfg.mType[m]    = Settings::s.motor[m].uiType;
                cfg.velLimit[m] = Settings::s.motor[m].velLimit;
                cfg.travVel[m]  = Settings::s.motor[m].traverseVel;
            }
            Display::drawConfig(cfg);
        } else {
            // Build display state snapshot from Core-0 volatiles.
            DisplayState ds;
            for (uint8_t si = 0; si < NUM_SERVOS; si++) {
                ds.servoActual[si] = (int)roundf(g_servoActual[si]);
                ds.servoTarget[si] = (int)roundf(g_servoTarget[si]);
            }
            for (uint8_t m = 0; m < NUM_MOTORS; m++) {
                ds.mode[m]           = (uint8_t)g_mode[m];
                ds.encoderOffline[m] = g_encoderOffline[m];
                ds.measVel[m]        = g_measVel[m];
                ds.measPosAbs[m]   = g_measPosAbs[m];
                ds.targetVel[m]    = g_targetVel[m];
                ds.commandedVel[m] = g_commandedVel[m];
                ds.targetPos[m]    = g_targetPos[m];
                ds.posError[m]     = g_posError[m];
                ds.duty[m]         = MotorPWM::rawDuty[m];
            }
            ds.animState      = g_animState;
            ds.animPattern    = g_animPattern;
            ds.animShowIntensity = g_animShowIntensity;
            // In DISABLED the only cursor item is EXIT (idx 4); no motor highlighted.
            ds.manualSel  = (g_appState == STATE_DISABLED) ? 4 : g_manualSel;
            ds.manualEdit = (g_appState == STATE_DISABLED) ? false : g_manualEdit;

            Display::update(g_appState, ds);
        }
    }

    delay(20);
}

// ---------------------------------------------------------------------------
// Core 0 — setup
// ---------------------------------------------------------------------------
void setup() {
    Serial.begin(115200);
    for (uint8_t i = 0; i < 20 && !Serial; i++) delay(50);

    pinMode(STATUS_LED_PIN, OUTPUT);
    digitalWrite(STATUS_LED_PIN, LOW);

    // I2CSlave::begin() intentionally omitted — Wire1 is now I2C master for
    // Motor 1 AS5600.  I2CSlave in-memory state is still used by console
    // command handlers; the watchdog in loop1() is harmlessly inactive.
    bool mag0Found = g_enc0.begin(AS5600_0_SDA_PIN, AS5600_0_SCL_PIN);
    bool mag1Found = g_enc1.begin(AS5600_1_SDA_PIN, AS5600_1_SCL_PIN);
    MotorPWM::begin();
    EndstopMonitor::begin();
    LocalUI::begin();

    const uint8_t servoPins[NUM_SERVOS] = { SERVO_0_PIN, SERVO_1_PIN };
    for (uint8_t i = 0; i < NUM_SERVOS; i++) g_servo[i].attach(servoPins[i]);

    Display::begin();
    DataLogger::begin();
    Settings::begin();
    applySettings();

    // Stations with a dedicated handler start immediately in RUN_AUTO at their
    // default intensity so the prop animates on power-up even with no
    // animation controller connected on the RS485 bus.
    if (stationAnim_hasHandler(Settings::s.nodeId)) {
        g_animState      = ANIMCOM_STATE_RUN_AUTO;
        g_animPattern    = 0;
        g_animShowIntensity = stationAnim_defaultShowIntensity(Settings::s.nodeId);
    }

    I2CSlave::lastCmdMs = millis();

    // AnimCom RS485 slave
    AnimComCallbacks acCb = {};
    acCb.onControlState  = onAnimControlState;
    acCb.onManualSingle  = onAnimManualSingle;
    acCb.onTriggerEffect = onAnimTriggerEffect;
    acCb.onWatchdog      = onAnimWatchdog;
    g_animcom.begin(acCb);
    g_animcom.setNodeId(Settings::s.nodeId);   // apply NVM node ID

    // Clear manual command timestamps so the ManualHold coast guard does not
    // fire before the first MANUAL_SINGLE frame arrives after startup.
    for (uint8_t m = 0; m < NUM_MOTORS; m++) g_lastManualCmdMs[m] = 0;

    Serial.println("[INFO] Dual wiper motor controller ready");
    if (!mag0Found) Serial.println("[WARN] Motor 0 AS5600 not found — check wiring");
    if (!mag1Found) Serial.println("[WARN] Motor 1 AS5600 not found — check wiring");
    Serial.println("[INFO] Type 'help' for command reference, 'help setup' for first-time tuning guide");
}

// ---------------------------------------------------------------------------
// Velocity measurement — sliding window average (VEL_WINDOW samples).
// Each motor maintains independent state via the m index.
// ---------------------------------------------------------------------------
static constexpr uint8_t VEL_WINDOW = 3;  // 3×20ms = 60ms window

static float measureVelocity(uint8_t m, uint16_t newAngle, float dt) {
    static uint16_t prevAngle  [NUM_MOTORS]              = {};
    static bool     firstSample[NUM_MOTORS]              = {true, true};
    static float    wDelta     [NUM_MOTORS][VEL_WINDOW]  = {};
    static float    wTime      [NUM_MOTORS][VEL_WINDOW]  = {};
    static uint8_t  wIdx       [NUM_MOTORS]              = {};
    static uint8_t  filled     [NUM_MOTORS]              = {};
    static float    sumDelta   [NUM_MOTORS]              = {};
    static float    sumTime    [NUM_MOTORS]              = {};

    if (firstSample[m]) {
        prevAngle[m]   = newAngle;
        firstSample[m] = false;
        return 0.0f;
    }

    int16_t raw = (int16_t)newAngle - (int16_t)prevAngle[m];
    if      (raw >  2048) raw -= 4096;
    else if (raw < -2048) raw += 4096;
    prevAngle[m] = newAngle;

    uint8_t i = wIdx[m];
    sumDelta[m] -= wDelta[m][i];
    sumTime[m]  -= wTime[m][i];
    wDelta[m][i] = (float)raw;
    wTime[m][i]  = dt;
    sumDelta[m] += wDelta[m][i];
    sumTime[m]  += wTime[m][i];
    wIdx[m] = (i + 1) % VEL_WINDOW;
    if (filled[m] < VEL_WINDOW) filled[m]++;

    if (sumTime[m] <= 0.0f) return 0.0f;
    return sumDelta[m] / sumTime[m] * (360.0f / 4096.0f);
}

// ---------------------------------------------------------------------------
// Control loop — 50 Hz gate, runs both motors each tick.
// ---------------------------------------------------------------------------
static void controlLoop(uint32_t now) {
    static uint32_t lastMs           = 0;
    static uint8_t  prevMode[NUM_MOTORS] = {MANUAL, MANUAL};

    if (now - lastMs < 20) return;
    float dt = (now - lastMs) * 0.001f;
    lastMs = now;

    applyAnimRunPattern(now);

    AS5600* encoders[NUM_MOTORS] = { &g_enc0, &g_enc1 };

    for (uint8_t m = 0; m < NUM_MOTORS; m++) {

        // --- Encoder read ---------------------------------------------
        uint16_t rawAngle = encoders[m]->readAngle();
        g_encoderOffline[m] = (rawAngle == 0xFFFF);
        if (rawAngle == 0xFFFF) {
            // Encoder required for closed-loop modes — coast immediately.
            // MANUAL (PWM) mode does not need the encoder; leave duty as-is.
            if (g_mode[m] == VELOCITY || g_mode[m] == POSITION) {
                MotorPWM::setMotor(m, MCP_SPEED_IDLE);
                g_pidOutput[m] = 0.0f;
                g_velPid[m].reset();
                g_posPid[m].reset();
            }
            continue;
        }
        if (m == 0) I2CSlave::encoderAngle = rawAngle;  // legacy compat
        g_lastRawAngle[m] = rawAngle;

        // Accumulate absolute multi-turn position.
        // Uses the same short-arc detection as measureVelocity so a single
        // 20 ms sample can never appear as more than a half-revolution step.
        //
        // On the FIRST read after boot, g_measPosAbs is seeded from the
        // actual physical position (encoder reading minus zeroOffset) rather
        // than starting at 0.  Without this, POSITION mode commands would
        // be relative to the power-on position rather than the calibrated
        // mechanical zero — causing the needle/actuator to drift further on
        // every reboot when a station animation targets an absolute angle.
        {
            static uint16_t prevRaw  [NUM_MOTORS] = {};
            static bool     firstRead[NUM_MOTORS] = {true, true};
            if (firstRead[m]) {
                prevRaw[m]   = rawAngle;
                firstRead[m] = false;
                // Seed absolute accumulator from calibrated physical position.
                float initPos = rawAngle * (360.0f / 4096.0f) - g_zeroOffset[m];
                // Normalise into (-180, +180] so the result is unambiguous for
                // single-revolution constrained motors (e.g. 0-180° gauges).
                if      (initPos >  180.0f) initPos -= 360.0f;
                else if (initPos < -180.0f) initPos += 360.0f;
                g_measPosAbs[m] = initPos;
            } else {
                int16_t delta = (int16_t)rawAngle - (int16_t)prevRaw[m];
                if      (delta >  2048) delta -= 4096;
                else if (delta < -2048) delta += 4096;
                prevRaw[m] = rawAngle;
                g_measPosAbs[m] += delta * (360.0f / 4096.0f);
            }
        }

        // Modular position (0–360°) — kept for I2C slave register and display
        float curPosDeg = rawAngle * (360.0f / 4096.0f) - g_zeroOffset[m];
        if      (curPosDeg <    0.0f) curPosDeg += 360.0f;
        else if (curPosDeg >= 360.0f) curPosDeg -= 360.0f;
        g_measPos[m] = curPosDeg;

        // --- Velocity measurement -------------------------------------
        float meas = measureVelocity(m, rawAngle, dt);
        g_measVel[m] = meas;
        if (m == 0) I2CSlave::measVelTenths = (int16_t)(meas * 10.0f);

        // --- Consume I2C commands (motor 0 only, legacy) --------------
        if (m == 0 && I2CSlave::newI2CCmd) {
            I2CSlave::newI2CCmd = false;
            ControlMode newMode = (ControlMode)I2CSlave::cmdMode;

            if (newMode == VELOCITY) {
                float vel = I2CSlave::cmdTargetVelTenths * 0.1f;
                g_targetVel[0] = vel;
                if (g_mode[0] != VELOCITY) g_velPid[0].reset();
            } else if (newMode == POSITION) {
                float pos = I2CSlave::cmdTargetPosTenths * 0.1f;
                g_targetPos[0] = pos;
                g_velPid[0].reset();
                g_posPid[0].reset();
                g_commandedPos[0] = (float)g_measPosAbs[0];
                g_mode[0] = POSITION;
            }
            if (newMode != g_mode[0]) {
                g_velPid[0].reset();
                g_posPid[0].reset();
                g_mode[0] = newMode;
            }
        }

        // --- ANIMCOM MANUAL hold: coast if no channel command recently ---
        // Both ManualRun and ManualHold send ANIMCOM_STATE_MANUAL keepalives.
        // ManualHold stops sending MANUAL_SINGLE frames, so per-motor timestamps
        // go stale.  Coast the motor until commands resume.
        if (g_appState == STATE_ANIMCOM &&
            g_animState == ANIMCOM_STATE_MANUAL &&
            g_lastManualCmdMs[m] != 0 &&
            (now - g_lastManualCmdMs[m]) > MANUAL_CMD_TIMEOUT_MS) {
            if (g_mode[m] != MANUAL) {
                g_mode[m] = MANUAL;
                g_velPid[m].reset();
                g_posPid[m].reset();
            }
            MotorPWM::setMotor(m, MCP_SPEED_IDLE);
            g_pidOutput[m] = 0.0f;
            continue;
        }

        // --- DISABLED: coast motor, skip PID entirely -----------------
        // Only enforce when the user has explicitly entered DISABLED (not while
        // browsing the menu, so console commands still work during menu nav).
        if (g_appState == STATE_DISABLED && !g_inMenu) {
            if (g_mode[m] != MANUAL) {
                g_mode[m] = MANUAL;
                g_velPid[m].reset();
                g_posPid[m].reset();
            }
            MotorPWM::setMotor(m, MCP_SPEED_IDLE);
            g_pidOutput[m] = 0.0f;
            continue;
        }

        // --- Reset PIDs on mode transition ----------------------------
        uint8_t curMode = g_mode[m];
        if (curMode != prevMode[m]) {
            g_velPid[m].reset();
            g_posPid[m].reset();
            if (curMode == VELOCITY)      g_commandedVel[m] = meas;
            else if (curMode == POSITION) g_commandedPos[m] = (float)g_measPosAbs[m];
        }
        prevMode[m] = curMode;

        // --- PID update -----------------------------------------------
        float logSetpoint = 0.0f;
        float logError    = 0.0f;
        float pidOut      = 0.0f;

        if (curMode == VELOCITY) {
            float cmdVel    = g_commandedVel[m];
            float tgtVel    = g_targetVel[m];
            float remaining = tgtVel - cmdVel;
            float step      = g_velAccel[m] * dt;
            if (fabsf(remaining) <= step) cmdVel = tgtVel;
            else cmdVel += (remaining > 0.0f) ? step : -step;
            g_commandedVel[m] = cmdVel;

            g_velPid[m].setSetpoint(cmdVel);
            pidOut      = g_velPid[m].update(meas, dt);
            logSetpoint = cmdVel;
            logError    = cmdVel - meas;

        } else if (curMode == POSITION) {
            // All position arithmetic is in absolute multi-turn degree space.
            // g_measPosAbs accumulates raw encoder deltas since the last zero,
            // so targets like 940° (≈2.6 revolutions) work directly with no
            // wraparound correction needed.
            float curAbs    = (float)g_measPosAbs[m];
            float cmdPos    = g_commandedPos[m];
            float tgtPos    = g_targetPos[m];
            float remaining = tgtPos - cmdPos;

            // Linear ramp toward target in absolute space
            float step = (float)g_traverseVel[m] * dt;
            if (fabsf(remaining) <= step) {
                cmdPos = tgtPos;
            } else {
                cmdPos += (remaining > 0.0f) ? step : -step;
            }
            g_commandedPos[m] = cmdPos;

            float posErr = cmdPos - curAbs;
            g_posError[m] = posErr;

            g_posPid[m].setSetpoint(cmdPos);
            float velCmd = g_posPid[m].update(curAbs, dt);
            g_targetVel[m] = velCmd;

            g_velPid[m].setSetpoint(velCmd);
            pidOut      = g_velPid[m].update(meas, dt);
            logSetpoint = cmdPos;
            logError    = posErr;
        }

        g_pidOutput[m] = pidOut;

        if (curMode == VELOCITY || curMode == POSITION) {
            int16_t duty = (int16_t)(pidOut * ((float)PWM_WRAP / 127.0f));
            MotorPWM::setMotorDuty(m, duty);
        }

        // Data logger — motor 0 only (single-channel logger)
        if (m == 0) {
            DataLogger::record(now,
                               logSetpoint, meas, logError,
                               pidOut, rawAngle, MotorPWM::rawDuty[0]);
        }
    }

    // --- RC servo ramp (both servos, same 50 Hz tick) ---
    for (uint8_t s = 0; s < NUM_SERVOS; s++) {
        float target = g_servoTarget[s];
        float actual = g_servoActual[s];
        float diff   = target - actual;
        float step   = g_servoRampRate[s] * dt;
        if (fabsf(diff) <= step) actual = target;
        else                     actual += (diff > 0.0f) ? step : -step;
        actual = constrain(actual, 0.0f, 180.0f);
        g_servoActual[s] = actual;
        g_servo[s].write((int)roundf(actual));
    }
}

// ---------------------------------------------------------------------------
// Console command helpers
// ---------------------------------------------------------------------------

// Print an error for a missing or out-of-range motor index.
static void printMotorIdxError(const String& cmd) {
    Serial.print("[ERR] "); Serial.print(cmd);
    Serial.print(": missing or invalid motor index (0–");
    Serial.print(NUM_MOTORS - 1); Serial.println(")");
}

// Parse "idx rest..." from a trimmed argument string.
// Returns false and prints an error if the index is missing or out of range.
static bool parseMotorIdx(const String& cmdName, const String& args,
                          uint8_t& outIdx, String& outRest) {
    String a = args;
    a.trim();
    if (a.length() == 0) { printMotorIdxError(cmdName); return false; }

    int sp = a.indexOf(' ');
    if (sp < 0) {
        outIdx  = (uint8_t)a.toInt();
        outRest = "";
    } else {
        outIdx  = (uint8_t)a.toInt();
        outRest = a.substring(sp + 1);
        outRest.trim();
    }
    if (outIdx >= NUM_MOTORS) { printMotorIdxError(cmdName); return false; }
    return true;
}

// Print gains for a single motor.
static void printGains(uint8_t m) {
    Serial.print("[M"); Serial.print(m);
    Serial.print(" VEL] kp="); Serial.print(g_velPid[m].kp, 4);
    Serial.print(" ki=");      Serial.print(g_velPid[m].ki, 4);
    Serial.print(" kd=");      Serial.print(g_velPid[m].kd, 4);
    Serial.print("  accel=");  Serial.print((float)g_velAccel[m], 1); Serial.println(" deg/s^2");

    Serial.print("[M"); Serial.print(m);
    Serial.print(" POS] kp="); Serial.print(g_posPid[m].kp, 4);
    Serial.print(" ki=");      Serial.print(g_posPid[m].ki, 4);
    Serial.print(" kd=");      Serial.print(g_posPid[m].kd, 4);
    Serial.print(" velLim=±"); Serial.print(POS_VEL_LIMIT, 1);
    Serial.print("  traverseVel="); Serial.print((float)g_traverseVel[m], 1); Serial.println(" deg/s");

    Serial.print("[M"); Serial.print(m);
    Serial.print(" POS] pathMode=");
    if (g_posPathMode[m] == POS_PATH_SHORTEST) {
        Serial.println("SHORTEST");
    } else {
        Serial.print("CONSTRAINED [");
        Serial.print((float)g_posMin[m], 1); Serial.print(", ");
        Serial.print((float)g_posMax[m], 1); Serial.println("] deg");
    }

    Serial.print("[M"); Serial.print(m);
    Serial.print(" CAL] zeroOffset="); Serial.print((float)g_zeroOffset[m], 2); Serial.println(" deg");
}

// ---------------------------------------------------------------------------
// Help text
// ---------------------------------------------------------------------------
static void printHelp() {
    Serial.println(F(""));
    Serial.println(F("=== WIPER MOTOR CONTROLLER — COMMAND REFERENCE ==="));
    Serial.println(F("  m = motor index (0 or 1)    idx = servo index (0 or 1)"));
    Serial.println(F(""));
    Serial.println(F("STREAM"));
    Serial.println(F("  stream on/off          Enable or disable the 2 Hz status printout"));
    Serial.println(F(""));
    Serial.println(F("MOTION  (require motor index m)"));
    Serial.println(F("  v <m> <deg/s>          Velocity mode — set target speed"));
    Serial.println(F("  va <m> <deg/s2>        Velocity ramp acceleration"));
    Serial.println(F("  p <m> <deg> [vel]      Position mode — move to angle (optional speed)"));
    Serial.println(F("  pv <m> <deg/s>         Position traverse speed"));
    Serial.println(F("  pmode <m> 0|1          Path: 0=SHORTEST  1=CONSTRAINED (uses plim)"));
    Serial.println(F("  plim <m> <min> <max>   Travel limits in degrees (CONSTRAINED mode)"));
    Serial.println(F("  r <m> <0-255>          Raw PWM: 0=rev-full  128=stop  255=fwd-full"));
    Serial.println(F("  stop [m]               Coast all motors (or just m) to idle"));
    Serial.println(F(""));
    Serial.println(F("CALIBRATION"));
    Serial.println(F("  zero <m>               Set current position as the zero reference"));
    Serial.println(F("  gains [m]              Print current PID gains (all, or just m)"));
    Serial.println(F(""));
    Serial.println(F("VELOCITY PID  (closed-loop speed control)"));
    Serial.println(F("  kp <m> <val>           Proportional gain"));
    Serial.println(F("  ki <m> <val>           Integral gain  (resets integrator)"));
    Serial.println(F("  kd <m> <val>           Derivative gain"));
    Serial.println(F(""));
    Serial.println(F("POSITION PID  (outputs velocity setpoint to inner velocity loop)"));
    Serial.println(F("  pkp <m> <val>          Proportional gain"));
    Serial.println(F("  pki <m> <val>          Integral gain  (resets integrator)"));
    Serial.println(F("  pkd <m> <val>          Derivative gain"));
    Serial.println(F(""));
    Serial.println(F("SERVO"));
    Serial.println(F("  servo <idx> <0-180>    Set RC servo target angle"));
    Serial.println(F("  servor <idx> <deg/s>   Set RC servo ramp rate"));
    Serial.println(F(""));
    Serial.println(F("CONFIGURATION"));
    Serial.println(F("  config                 Print all saved configuration"));
    Serial.println(F("  nodeid [id]            Get/set RS485 station ID (hex ok: 0x07)"));
    Serial.println(F("  mtype <m> [0|1|2]      Display type: 0=PWM%  1=VELOCITY  2=POSITION"));
    Serial.println(F("  mvellim <m> [val]      Velocity cap 10-720 deg/s"));
    Serial.println(F("  mtravvel <m> [val]     Default traverse velocity 10-720 deg/s"));
    Serial.println(F(""));
    Serial.println(F("SETTINGS"));
    Serial.println(F("  save                   Write all RAM settings to flash"));
    Serial.println(F("  load                   Reload settings from flash"));
    Serial.println(F("  defaults               Restore factory defaults (RAM only)"));
    Serial.println(F(""));
    Serial.println(F("DIAGNOSTICS"));
    Serial.println(F("  freeze                 Stop all motors and dump DataLogger to console"));
    Serial.println(F("  resume                 Resume DataLogger recording after freeze"));
    Serial.println(F(""));
    Serial.println(F("SYSTEM"));
    Serial.println(F("  bootload               Reboot into BOOTSEL/UF2 flash mode"));
    Serial.println(F(""));
    Serial.println(F("  help setup             Step-by-step guide: first-time setup and tuning"));
    Serial.println(F("==================================================="));
}

static void printSetupGuide() {
    Serial.println(F(""));
    Serial.println(F("=== NEW MOTOR SETUP GUIDE ==="));
    Serial.println(F(""));
    Serial.println(F("STEP 1 — VERIFY ENCODER"));
    Serial.println(F("  With stream running, rotate the shaft by hand."));
    Serial.println(F("  Confirm the Abs value in the status line changes."));
    Serial.println(F("  If 'ENCODER OFFLINE' appears: check AS5600 wiring"));
    Serial.println(F("  (SDA/SCL/3.3V/GND) and confirm the diametric magnet"));
    Serial.println(F("  is centred over the AS5600 IC within 0.5 mm."));
    Serial.println(F(""));
    Serial.println(F("STEP 2 — SET ZERO POSITION"));
    Serial.println(F("  Move the mechanism to the desired home/zero position."));
    Serial.println(F("    zero <m>       Sets current angle as origin"));
    Serial.println(F("    save           Persist to flash"));
    Serial.println(F("  The Abs value should now read ~0.0 deg."));
    Serial.println(F(""));
    Serial.println(F("STEP 3 — SET TRAVEL LIMITS  (position-controlled mechanisms)"));
    Serial.println(F("  Move shaft to minimum stop, note Abs value."));
    Serial.println(F("  Move shaft to maximum stop, note Abs value."));
    Serial.println(F("    plim <m> <min> <max>   e.g. plim 0 0 180"));
    Serial.println(F("    pmode <m> 1            Enable CONSTRAINED mode"));
    Serial.println(F(""));
    Serial.println(F("STEP 4 — SET MOTOR DISPLAY TYPE"));
    Serial.println(F("    mtype <m> 0   PWM percent   (open-loop, no encoder needed)"));
    Serial.println(F("    mtype <m> 1   VELOCITY       (closed-loop deg/s)"));
    Serial.println(F("    mtype <m> 2   POSITION       (closed-loop degrees)"));
    Serial.println(F(""));
    Serial.println(F("STEP 5 — TUNE VELOCITY PID"));
    Serial.println(F("  Turn stream off to keep console readable."));
    Serial.println(F("    stream off"));
    Serial.println(F("    v <m> 90          Command 90 deg/s"));
    Serial.println(F("    gains <m>         View current gains"));
    Serial.println(F("  Starting point:  kp=0.5  ki=0.3  kd=0.0"));
    Serial.println(F("  Too slow/weak:   increase kp"));
    Serial.println(F("  Oscillating:     decrease kp, add small kd"));
    Serial.println(F("  Steady error:    increase ki (0.05-0.1 increments)"));
    Serial.println(F("  Use 'stream on' briefly to observe, then off again."));
    Serial.println(F("    stop <m>          Stop when done"));
    Serial.println(F("    save              Persist gains"));
    Serial.println(F(""));
    Serial.println(F("STEP 6 — TUNE POSITION PID"));
    Serial.println(F("  The position PID outputs a velocity setpoint fed into"));
    Serial.println(F("  the velocity loop — tune velocity first (Step 5)."));
    Serial.println(F("    p <m> 90          Move to 90 deg"));
    Serial.println(F("    p <m> 0           Return to zero"));
    Serial.println(F("  Starting point:  pkp=2.0  pki=0.0  pkd=0.0"));
    Serial.println(F("  Too slow:        increase pkp"));
    Serial.println(F("  Overshoot:       decrease pkp or lower pv (traverse speed)"));
    Serial.println(F("  Hunting/buzzing: reduce pkp; ensure velocity loop is stable"));
    Serial.println(F("  Steady offset:   add small pki (0.05 increments)"));
    Serial.println(F("    save            Persist gains"));
    Serial.println(F(""));
    Serial.println(F("STEP 7 — SET VELOCITY AND TRAVERSE LIMITS"));
    Serial.println(F("    mvellim <m> <val>    Max speed cap for PID output (deg/s)"));
    Serial.println(F("                         Start at 180.  Lower = smoother, slower."));
    Serial.println(F("    mtravvel <m> <val>   Default speed for 'p' commands (deg/s)"));
    Serial.println(F("                         Start at 90."));
    Serial.println(F("    save"));
    Serial.println(F(""));
    Serial.println(F("STEP 8 — SET RS485 NODE ID  (AnimCom controller)"));
    Serial.println(F("    nodeid 0x07          Must match animation controller config"));
    Serial.println(F("    save"));
    Serial.println(F(""));
    Serial.println(F("Type 'help' for full command reference."));
    Serial.println(F("============================="));
}

// ---------------------------------------------------------------------------
// Console command processor
// ---------------------------------------------------------------------------
static void processCommand(const String& raw) {
    String cmd = raw;
    cmd.trim();
    if (cmd.length() == 0) return;

    uint8_t m;
    String  rest;

    // ---- Help --------------------------------------------------------
    if (cmd.equalsIgnoreCase("help")) {
        printHelp();
        return;

    } else if (cmd.equalsIgnoreCase("help setup")) {
        printSetupGuide();
        return;

    // ---- Data logger commands (no motor index) -----------------------
    } else if (cmd.equalsIgnoreCase("freeze")) {
        for (uint8_t i = 0; i < NUM_MOTORS; i++) {
            g_mode[i] = MANUAL;
            g_velPid[i].reset();
            g_posPid[i].reset();
            MotorPWM::setMotor(i, MCP_SPEED_IDLE);
        }
        DataLogger::freeze();
        Serial.print("# Frozen — ");
        Serial.print(DataLogger::count());
        Serial.print(" records (");
        Serial.print(DataLogger::count() / 50.0f, 1);
        Serial.println("s)\n");
        DataLogger::dump();
        return;

    } else if (cmd.equalsIgnoreCase("resume")) {
        DataLogger::resume();
        Serial.println("[LOG] Recording resumed");
        return;

    // ---- NVM commands (no motor index) -------------------------------
    } else if (cmd.equalsIgnoreCase("save")) {
        captureSettings();
        Settings::save();
        Serial.println("[NVM] All motor settings saved to flash");
        return;

    } else if (cmd.equalsIgnoreCase("load")) {
        if (Settings::load()) {
            applySettings();
            for (uint8_t i = 0; i < NUM_MOTORS; i++) {
                g_velPid[i].reset();
                g_posPid[i].reset();
            }
            Serial.println("[NVM] Settings loaded from flash (applied to all motors)");
        } else {
            Serial.println("[NVM] No valid settings in flash — use 'save' to store current values");
        }
        return;

    } else if (cmd.equalsIgnoreCase("defaults")) {
        Settings::defaults();
        applySettings();
        for (uint8_t i = 0; i < NUM_MOTORS; i++) {
            g_velPid[i].reset();
            g_posPid[i].reset();
        }
        Serial.println("[NVM] Factory defaults applied to all motors (RAM only — type 'save' to persist)");
        return;

    } else if (cmd.equalsIgnoreCase("stream on")) {
        g_streamEnabled = true;
        Serial.println("[INFO] Status stream enabled");
        return;

    } else if (cmd.equalsIgnoreCase("stream off")) {
        g_streamEnabled = false;
        Serial.println("[INFO] Status stream disabled");
        return;

    } else if (cmd.equalsIgnoreCase("bootload")) {
        Serial.println("[SYS] Rebooting to BOOTSEL (UF2) mode — board will appear as RPI-RP2 drive");
        Serial.flush();
        delay(100);
        rp2040.rebootToBootloader();
        return;

    // ---- gains (optional motor index) --------------------------------
    } else if (cmd.equalsIgnoreCase("gains")) {
        for (uint8_t i = 0; i < NUM_MOTORS; i++) printGains(i);
        Serial.println("[NVM] (RAM values — type 'save' to persist, 'load' to revert)");
        return;

    } else if (cmd.startsWith("gains ") || cmd.startsWith("GAINS ")) {
        if (!parseMotorIdx("gains", cmd.substring(6), m, rest)) return;
        printGains(m);
        return;

    // ---- stop (optional motor index: omit = all) ---------------------
    } else if (cmd.equalsIgnoreCase("stop")) {
        for (uint8_t i = 0; i < NUM_MOTORS; i++) {
            g_mode[i] = MANUAL;
            g_velPid[i].reset();
            g_posPid[i].reset();
            MotorPWM::setMotor(i, MCP_SPEED_IDLE);
        }
        I2CSlave::lastCmdMs = millis();
        Serial.println("[CMD] All motors stopped");
        return;

    } else if (cmd.startsWith("stop ") || cmd.startsWith("STOP ")) {
        if (!parseMotorIdx("stop", cmd.substring(5), m, rest)) return;
        g_mode[m] = MANUAL;
        g_velPid[m].reset();
        g_posPid[m].reset();
        MotorPWM::setMotor(m, MCP_SPEED_IDLE);
        if (m == 0) I2CSlave::lastCmdMs = millis();
        Serial.print("[CMD] M"); Serial.print(m); Serial.println(" stopped");
        return;

    // ---- velocity ----------------------------------------------------
    } else if (cmd.startsWith("va ") || cmd.startsWith("VA ")) {
        if (!parseMotorIdx("va", cmd.substring(3), m, rest)) return;
        if (rest.length() == 0) { Serial.println("[ERR] va: missing accel value"); return; }
        float accel = max(1.0f, rest.toFloat());
        g_velAccel[m] = accel;
        Serial.print("[M"); Serial.print(m);
        Serial.print(" CMD] Velocity accel "); Serial.print(accel, 1); Serial.println(" deg/s^2");
        return;

    } else if (cmd.startsWith("v ") || cmd.startsWith("V ") || cmd.startsWith("vel ")) {
        uint8_t pfx = cmd.startsWith("vel") ? 4 : 2;
        if (!parseMotorIdx("v", cmd.substring(pfx), m, rest)) return;
        if (rest.length() == 0) { Serial.println("[ERR] v: missing velocity value"); return; }
        float vel = rest.toFloat();
        g_targetVel[m] = vel;
        if (g_mode[m] != VELOCITY) {
            g_velPid[m].reset();
            g_posPid[m].reset();
            g_mode[m] = VELOCITY;
        }
        if (m == 0) {
            I2CSlave::cmdMode            = MCP_MODE_VELOCITY;
            I2CSlave::cmdTargetVelTenths = (int16_t)(vel * 10.0f);
            I2CSlave::lastCmdMs          = millis();
        }
        Serial.print("[M"); Serial.print(m);
        Serial.print(" CMD] Velocity "); Serial.print(vel, 1); Serial.println(" deg/s");
        return;

    // ---- position ----------------------------------------------------
    } else if (cmd.startsWith("pv ") || cmd.startsWith("PV ")) {
        if (!parseMotorIdx("pv", cmd.substring(3), m, rest)) return;
        if (rest.length() == 0) { Serial.println("[ERR] pv: missing velocity value"); return; }
        float vel = max(1.0f, rest.toFloat());
        g_traverseVel[m] = vel;
        Serial.print("[M"); Serial.print(m);
        Serial.print(" CMD] Traverse velocity "); Serial.print(vel, 1); Serial.println(" deg/s");
        return;

    } else if (cmd.startsWith("pmode") || cmd.startsWith("PMODE")) {
        if (!parseMotorIdx("pmode", cmd.substring(5), m, rest)) return;
        if (rest.length() == 0) { Serial.println("[ERR] pmode: missing 0 or 1"); return; }
        g_posPathMode[m] = ((int)rest.toFloat() == 0) ? POS_PATH_SHORTEST : POS_PATH_CONSTRAINED;
        Serial.print("[M"); Serial.print(m); Serial.print(" POS] Path mode: ");
        if (g_posPathMode[m] == POS_PATH_SHORTEST) {
            Serial.println("SHORTEST (wrap-around allowed)");
        } else {
            Serial.print("CONSTRAINED [");
            Serial.print((float)g_posMin[m], 1); Serial.print(", ");
            Serial.print((float)g_posMax[m], 1); Serial.println("] deg");
        }
        return;

    } else if (cmd.startsWith("plim") || cmd.startsWith("PLIM")) {
        if (!parseMotorIdx("plim", cmd.substring(4), m, rest)) return;
        int sp = rest.indexOf(' ');
        if (sp <= 0) { Serial.println("[ERR] Usage: plim <m> <min> <max>"); return; }
        float lo = rest.toFloat();
        float hi = rest.substring(sp + 1).toFloat();
        if (hi <= lo) { Serial.println("[ERR] plim: max must be > min"); return; }
        g_posMin[m] = lo;
        g_posMax[m] = hi;
        Serial.print("[M"); Serial.print(m); Serial.print(" POS] Limits set: [");
        Serial.print(lo, 1); Serial.print(", "); Serial.print(hi, 1); Serial.println("] deg");
        return;

    } else if (cmd.startsWith("p ") || cmd.startsWith("P ")) {
        if (!parseMotorIdx("p", cmd.substring(2), m, rest)) return;
        if (rest.length() == 0) { Serial.println("[ERR] p: missing position value"); return; }

        int sp = rest.indexOf(' ');
        float pos = rest.toFloat();

        // Targets are absolute multi-turn degrees — 940°, -180°, etc. are all valid.
        // CONSTRAINED mode clamps to the configured absolute travel limits.
        if (g_posPathMode[m] == POS_PATH_CONSTRAINED) {
            float lo = g_posMin[m], hi = g_posMax[m];
            if      (pos < lo) { pos = lo; Serial.print("[WARN] Position clamped to "); Serial.print(lo, 1); Serial.println(" deg"); }
            else if (pos > hi) { pos = hi; Serial.print("[WARN] Position clamped to "); Serial.print(hi, 1); Serial.println(" deg"); }
        }
        g_targetPos[m] = pos;

        if (sp > 0) {
            float vel = rest.substring(sp + 1).toFloat();
            if (vel >= 1.0f) g_traverseVel[m] = vel;
        }

        g_velPid[m].reset();
        g_posPid[m].reset();
        g_commandedPos[m] = (float)g_measPosAbs[m];
        g_mode[m] = POSITION;

        if (m == 0) {
            I2CSlave::cmdMode            = MCP_MODE_POSITION;
            I2CSlave::cmdTargetPosTenths = (uint16_t)(pos * 10.0f);
            I2CSlave::lastCmdMs          = millis();
        }
        Serial.print("[M"); Serial.print(m);
        Serial.print(" CMD] Position "); Serial.print(pos, 1);
        Serial.print(" deg  @ "); Serial.print((float)g_traverseVel[m], 1); Serial.println(" deg/s");
        return;

    // ---- raw PWM -----------------------------------------------------
    } else if (cmd.startsWith("r ") || cmd.startsWith("R ") || cmd.startsWith("raw ")) {
        uint8_t pfx = cmd.startsWith("raw") ? 4 : 2;
        if (!parseMotorIdx("r", cmd.substring(pfx), m, rest)) return;
        if (rest.length() == 0) { Serial.println("[ERR] r: missing PWM value (0–255)"); return; }
        int val = constrain((int)rest.toFloat(), 0, 255);
        g_mode[m] = MANUAL;
        g_velPid[m].reset();
        g_posPid[m].reset();
        MotorPWM::setMotor(m, (uint8_t)val);
        if (m == 0) I2CSlave::lastCmdMs = millis();
        Serial.print("[M"); Serial.print(m);
        Serial.print(" CMD] Raw "); Serial.println(val);
        return;

    // ---- calibration -------------------------------------------------
    } else if (cmd.startsWith("zero") || cmd.startsWith("ZERO")) {
        if (!parseMotorIdx("zero", cmd.substring(4), m, rest)) return;
        float rawDeg = g_lastRawAngle[m] * (360.0f / 4096.0f);
        g_zeroOffset[m]   = rawDeg;   // keeps the modular 0–360 display correct
        g_measPosAbs[m]   = 0.0f;     // reset multi-turn accumulator to zero
        g_commandedPos[m] = 0.0f;     // prevent a jump if already in position mode
        g_targetPos[m]    = 0.0f;
        Serial.print("[M"); Serial.print(m);
        Serial.println(" CAL] Zero set — absolute position reset to 0 (RAM only — type 'save' to persist)");
        return;

    // ---- PID gain commands -------------------------------------------
    } else if (cmd.startsWith("pkp") || cmd.startsWith("Pkp") || cmd.startsWith("PKP")) {
        if (!parseMotorIdx("pkp", cmd.substring(3), m, rest)) return;
        if (rest.length() == 0) { Serial.println("[ERR] pkp: missing value"); return; }
        g_posPid[m].kp = rest.toFloat();
        Serial.print("[M"); Serial.print(m); Serial.print(" POS] kp="); Serial.println(g_posPid[m].kp, 4);
        return;

    } else if (cmd.startsWith("pki") || cmd.startsWith("Pki") || cmd.startsWith("PKI")) {
        if (!parseMotorIdx("pki", cmd.substring(3), m, rest)) return;
        if (rest.length() == 0) { Serial.println("[ERR] pki: missing value"); return; }
        g_posPid[m].ki = rest.toFloat();
        g_posPid[m].reset();
        Serial.print("[M"); Serial.print(m); Serial.print(" POS] ki="); Serial.println(g_posPid[m].ki, 4);
        return;

    } else if (cmd.startsWith("pkd") || cmd.startsWith("Pkd") || cmd.startsWith("PKD")) {
        if (!parseMotorIdx("pkd", cmd.substring(3), m, rest)) return;
        if (rest.length() == 0) { Serial.println("[ERR] pkd: missing value"); return; }
        g_posPid[m].kd = rest.toFloat();
        Serial.print("[M"); Serial.print(m); Serial.print(" POS] kd="); Serial.println(g_posPid[m].kd, 4);
        return;

    } else if (cmd.startsWith("kp") || cmd.startsWith("Kp") || cmd.startsWith("KP")) {
        if (!parseMotorIdx("kp", cmd.substring(2), m, rest)) return;
        if (rest.length() == 0) { Serial.println("[ERR] kp: missing value"); return; }
        g_velPid[m].kp = rest.toFloat();
        Serial.print("[M"); Serial.print(m); Serial.print(" VEL] kp="); Serial.println(g_velPid[m].kp, 4);
        return;

    } else if (cmd.startsWith("ki") || cmd.startsWith("Ki") || cmd.startsWith("KI")) {
        if (!parseMotorIdx("ki", cmd.substring(2), m, rest)) return;
        if (rest.length() == 0) { Serial.println("[ERR] ki: missing value"); return; }
        g_velPid[m].ki = rest.toFloat();
        g_velPid[m].reset();
        Serial.print("[M"); Serial.print(m); Serial.print(" VEL] ki="); Serial.println(g_velPid[m].ki, 4);
        return;

    } else if (cmd.startsWith("kd") || cmd.startsWith("Kd") || cmd.startsWith("KD")) {
        if (!parseMotorIdx("kd", cmd.substring(2), m, rest)) return;
        if (rest.length() == 0) { Serial.println("[ERR] kd: missing value"); return; }
        g_velPid[m].kd = rest.toFloat();
        Serial.print("[M"); Serial.print(m); Serial.print(" VEL] kd="); Serial.println(g_velPid[m].kd, 4);
        return;

    // ---- RC servo ramp rate ------------------------------------------
    } else if (cmd.startsWith("servor ") || cmd.startsWith("SERVOR ")) {
        String args = cmd.substring(7);
        args.trim();
        int sp = args.indexOf(' ');
        if (sp <= 0) { Serial.println("[ERR] Usage: servor <idx> <rate deg/s>"); return; }
        uint8_t idx  = (uint8_t)args.toInt();
        float   rate = args.substring(sp + 1).toFloat();
        if (idx >= NUM_SERVOS) {
            Serial.print("[ERR] servor: invalid index (0–"); Serial.print(NUM_SERVOS - 1); Serial.println(")");
            return;
        }
        g_servoRampRate[idx] = max(1.0f, rate);
        Serial.print("[SERVO"); Serial.print(idx); Serial.print("] ramp rate ");
        Serial.print(g_servoRampRate[idx], 1); Serial.println(" deg/s");
        return;

    // ---- RC servo ----------------------------------------------------
    } else if (cmd.startsWith("servo ") || cmd.startsWith("SERVO ")) {
        String args = cmd.substring(6);
        args.trim();
        int sp = args.indexOf(' ');
        if (sp <= 0) { Serial.println("[ERR] Usage: servo <idx> <angle 0-180>"); return; }
        uint8_t idx   = (uint8_t)args.toInt();
        float   angle = args.substring(sp + 1).toFloat();
        if (idx >= NUM_SERVOS) {
            Serial.print("[ERR] servo: invalid index (0–"); Serial.print(NUM_SERVOS - 1); Serial.println(")");
            return;
        }
        int deg = constrain((int)angle, 0, 180);
        g_servoTarget[idx] = (float)deg;
        Serial.print("[SERVO"); Serial.print(idx); Serial.print("] target "); Serial.print(deg);
        Serial.print(" deg  ramp "); Serial.print(g_servoRampRate[idx], 1); Serial.println(" deg/s");
        return;

    // ---- config — print all UI configuration params -------------------
    } else if (cmd.equalsIgnoreCase("config")) {
        Serial.printf("[CFG] nodeId=0x%02X\n", Settings::s.nodeId);
        static const char* kTypeNames[] = { "PWM%", "VELOCITY", "POSITION" };
        for (uint8_t m = 0; m < NUM_MOTORS; m++) {
            const NvmSettings::MotorSettings& ms = Settings::s.motor[m];
            uint8_t t = ms.uiType < 3 ? ms.uiType : 0;
            Serial.printf("[CFG] M%d type=%s  velLimit=%.1f deg/s  traverseVel=%.1f deg/s\n",
                          m, kTypeNames[t], ms.velLimit, ms.traverseVel);
        }
        return;

    // ---- nodeid [val] — get/set RS485 station ID ----------------------
    } else if (cmd.startsWith("nodeid") || cmd.startsWith("NODEID")) {
        String args = cmd.substring(6);
        args.trim();
        if (args.length() == 0) {
            Serial.printf("[CFG] nodeId=0x%02X\n", Settings::s.nodeId);
        } else {
            uint8_t id = (uint8_t)strtoul(args.c_str(), nullptr, 0);
            if (id < 1 || id > 0xFE) {
                Serial.println("[ERR] nodeid: valid range 0x01–0xFE");
            } else {
                Settings::s.nodeId = id;
                g_animcom.setNodeId(id);
                Serial.printf("[CFG] nodeId=0x%02X (type 'save' to persist)\n", id);
            }
        }
        return;

    // ---- mtype <m> [0|1|2] — get/set motor UI type --------------------
    } else if (cmd.startsWith("mtype ") || cmd.startsWith("MTYPE ")) {
        uint8_t m; String rest;
        if (!parseMotorIdx("mtype", cmd.substring(6), m, rest)) return;
        static const char* kTypeNames2[] = { "PWM%", "VELOCITY", "POSITION" };
        if (rest.length() == 0) {
            uint8_t t = Settings::s.motor[m].uiType;
            Serial.printf("[CFG] M%d type=%s (%d)\n", m, kTypeNames2[t < 3 ? t : 0], t);
        } else {
            uint8_t t = (uint8_t)rest.toInt();
            if (t > 2) { Serial.println("[ERR] mtype: 0=PWM%  1=VELOCITY  2=POSITION"); return; }
            Settings::s.motor[m].uiType = t;
            Serial.printf("[CFG] M%d type=%s (type 'save' to persist)\n", m, kTypeNames2[t]);
        }
        return;

    // ---- mvellim <m> [val] — get/set motor velocity limit (deg/s) -----
    } else if (cmd.startsWith("mvellim ") || cmd.startsWith("MVELLIM ")) {
        uint8_t m; String rest;
        if (!parseMotorIdx("mvellim", cmd.substring(8), m, rest)) return;
        if (rest.length() == 0) {
            Serial.printf("[CFG] M%d velLimit=%.1f deg/s\n", m, Settings::s.motor[m].velLimit);
        } else {
            float v = rest.toFloat();
            if (v < 10.0f || v > 720.0f) { Serial.println("[ERR] mvellim: range 10–720 deg/s"); return; }
            Settings::s.motor[m].velLimit = v;
            Serial.printf("[CFG] M%d velLimit=%.1f deg/s (type 'save' to persist)\n", m, v);
        }
        return;

    // ---- mtravvel <m> [val] — get/set position traverse velocity -------
    } else if (cmd.startsWith("mtravvel ") || cmd.startsWith("MTRAVVEL ")) {
        uint8_t m; String rest;
        if (!parseMotorIdx("mtravvel", cmd.substring(9), m, rest)) return;
        if (rest.length() == 0) {
            Serial.printf("[CFG] M%d traverseVel=%.1f deg/s\n", m, Settings::s.motor[m].traverseVel);
        } else {
            float v = rest.toFloat();
            if (v < 10.0f || v > 720.0f) { Serial.println("[ERR] mtravvel: range 10–720 deg/s"); return; }
            Settings::s.motor[m].traverseVel = v;
            g_traverseVel[m] = v;
            Serial.printf("[CFG] M%d traverseVel=%.1f deg/s (type 'save' to persist)\n", m, v);
        }
        return;

    // ---- Unknown command ---------------------------------------------
    } else {
        Serial.print("[ERR] Unknown command: "); Serial.println(cmd);
        Serial.println("[ERR] Type 'help' for command reference, 'help setup' for tuning guide");
    }
}

// ---------------------------------------------------------------------------
// Console input handler — assembles characters into lines.
// ---------------------------------------------------------------------------
static String  g_serialBuf;

static void handleConsoleInput() {
    while (Serial.available()) {
        char c = (char)Serial.read();
        if (c == '\n' || c == '\r') {
            processCommand(g_serialBuf);
            g_serialBuf = "";
        } else if (g_serialBuf.length() < 32) {
            g_serialBuf += c;
        }
    }
}

// ---------------------------------------------------------------------------
// Core 0 — main loop: control only, no Serial output.
// ---------------------------------------------------------------------------
void loop() {
    uint32_t now = millis();
    g_animcom.poll();
    handleConsoleInput();

    // ---- Top-level UI navigation (rotary encoder + pushbutton) ----
    int16_t encDelta = LocalUI::encoderDelta();
    bool    btnPress = LocalUI::buttonPressed();


    if (g_inMenu) {
        // Encoder scrolls through menu items.
        if (encDelta != 0) {
            int8_t sel = (int8_t)g_menuSel + (encDelta > 0 ? 1 : -1);
            if (sel < 0)                       sel = (int8_t)NUM_APP_STATES - 1;
            if (sel >= (int8_t)NUM_APP_STATES) sel = 0;
            g_menuSel = (uint8_t)sel;
        }
        // Button enters the highlighted mode.
        if (btnPress) {
            AppState entering = (AppState)g_menuSel;
            g_appState = entering;
            g_inMenu   = false;
            g_manualSel  = 0;
            g_manualEdit = false;
            g_cfgSel     = 0;
            g_cfgEdit   = false;
            if (entering == STATE_ANIMCOM) {
                // Clear timestamps so the hold-timeout doesn't fire before
                // the first MANUAL_SINGLE frame arrives.
                for (uint8_t m = 0; m < NUM_MOTORS; m++) g_lastManualCmdMs[m] = 0;
            }
            if (entering == STATE_DISABLED) {
                coastAll();
                for (uint8_t s = 0; s < NUM_SERVOS; s++) g_servoTarget[s] = 90.0f;
            }
        }

    } else if (g_appState == STATE_CONFIG) {
        // ---- Config screen navigation -----------------------------------
        if (encDelta != 0) {
            int8_t d = (encDelta > 0) ? 1 : -1;
            if (!g_cfgEdit) {
                // Scroll items.
                int8_t sel = (int8_t)g_cfgSel + d;
                if (sel < 0)                     sel = (int8_t)NUM_CFG_ITEMS - 1;
                if (sel >= (int8_t)NUM_CFG_ITEMS) sel = 0;
                g_cfgSel = (uint8_t)sel;
            } else {
                // Adjust selected item value.
                switch ((CfgItem)g_cfgSel) {
                    case CFG_NODE_ID: {
                        int16_t v = (int16_t)Settings::s.nodeId + d;
                        if (v < 1)    v = 0xFE;
                        if (v > 0xFE) v = 1;
                        Settings::s.nodeId = (uint8_t)v;
                        g_animcom.setNodeId(Settings::s.nodeId);
                        break;
                    }
                    case CFG_M0_TYPE: {
                        int8_t v = (int8_t)Settings::s.motor[0].uiType + d;
                        if (v < 0) v = 2;  if (v > 2) v = 0;
                        Settings::s.motor[0].uiType = (uint8_t)v;
                        break;
                    }
                    case CFG_M0_VELLIM: {
                        float v = Settings::s.motor[0].velLimit + d * 5.0f;
                        Settings::s.motor[0].velLimit = constrain(v, 10.0f, 720.0f);
                        break;
                    }
                    case CFG_M0_TRAVVEL: {
                        float v = Settings::s.motor[0].traverseVel + d * 5.0f;
                        Settings::s.motor[0].traverseVel = constrain(v, 10.0f, 720.0f);
                        g_traverseVel[0] = Settings::s.motor[0].traverseVel;
                        break;
                    }
                    case CFG_M1_TYPE: {
                        int8_t v = (int8_t)Settings::s.motor[1].uiType + d;
                        if (v < 0) v = 2;  if (v > 2) v = 0;
                        Settings::s.motor[1].uiType = (uint8_t)v;
                        break;
                    }
                    case CFG_M1_VELLIM: {
                        float v = Settings::s.motor[1].velLimit + d * 5.0f;
                        Settings::s.motor[1].velLimit = constrain(v, 10.0f, 720.0f);
                        break;
                    }
                    case CFG_M1_TRAVVEL: {
                        float v = Settings::s.motor[1].traverseVel + d * 5.0f;
                        Settings::s.motor[1].traverseVel = constrain(v, 10.0f, 720.0f);
                        g_traverseVel[1] = Settings::s.motor[1].traverseVel;
                        break;
                    }
                    default: break;
                }
            }
        }
        if (btnPress) {
            if ((CfgItem)g_cfgSel == CFG_SAVE) {
                // Save to flash then return to menu.
                captureSettings();
                Settings::save();
                Serial.printf("[NVM] Config saved — nodeId=0x%02X\n", Settings::s.nodeId);
                coastAll();
                g_inMenu = true;
            } else if ((CfgItem)g_cfgSel == CFG_EXIT) {
                // Discard unsaved changes by reloading the last saved flash state,
                // then return to the menu without touching motor output.
                if (!Settings::load()) Settings::defaults();
                applySettings();
                for (uint8_t i = 0; i < NUM_MOTORS; i++) {
                    g_velPid[i].reset();
                    g_posPid[i].reset();
                }
                Serial.println("[CFG] Exit without save — settings reloaded from flash");
                g_inMenu = true;
            } else if (g_cfgEdit) {
                g_cfgEdit = false;   // confirm edit, return to scroll
            } else {
                g_cfgEdit = true;    // enter edit mode for this item
            }
        }

    } else if (g_appState == STATE_MANUAL) {
        // ---- MANUAL mode ------------------------------------------------
        // Two sub-modes:
        //   Scroll mode  — encoder moves cursor between items; button selects.
        //   Adjust mode  — encoder changes the selected motor/servo setpoint;
        //                  button returns to scroll mode.

        if (!g_manualEdit) {
            // --- Scroll mode ---
            if (encDelta != 0) {
                int8_t sel = (int8_t)g_manualSel + (encDelta > 0 ? 1 : -1);
                if (sel < 0)                          sel = MANUAL_EXIT_IDX;
                if (sel > (int8_t)MANUAL_EXIT_IDX)    sel = 0;
                g_manualSel = (uint8_t)sel;
            }
            if (btnPress) {
                if (g_manualSel == MANUAL_EXIT_IDX) {
                    coastAll();
                    g_inMenu = true;
                } else {
                    g_manualEdit = true;   // enter adjust mode for this item
                }
            }
        } else {
            // --- Adjust mode ---
            if (encDelta != 0) {
                int8_t  d   = (encDelta > 0) ? 1 : -1;
                uint8_t sel = g_manualSel;

                if (sel < NUM_MOTORS) {
                    // DC motor adjustment
                    uint8_t m = sel;
                    switch ((UiMotorType)Settings::s.motor[m].uiType) {
                        case UI_PWM_PERCENT: {
                            int16_t step = (int16_t)(PWM_WRAP / 100);  // 1% per step
                            int32_t duty = (int32_t)MotorPWM::rawDuty[m] + d * step;
                            duty = constrain(duty, -(int32_t)PWM_WRAP, (int32_t)PWM_WRAP);
                            g_mode[m] = MANUAL;
                            MotorPWM::setMotorDuty(m, (int16_t)duty);
                            break;
                        }
                        case UI_VELOCITY: {
                            float limit = Settings::s.motor[m].velLimit;
                            float vel   = g_targetVel[m] + d * 5.0f;
                            vel = constrain(vel, -limit, limit);
                            g_targetVel[m] = vel;
                            if (g_mode[m] != VELOCITY) g_velPid[m].reset();
                            g_mode[m] = VELOCITY;
                            break;
                        }
                        case UI_POSITION: {
                            float pos = g_targetPos[m] + d * 5.0f;
                            if (g_mode[m] != POSITION) {
                                g_velPid[m].reset();
                                g_posPid[m].reset();
                                g_commandedPos[m] = (float)g_measPosAbs[m];
                            }
                            g_targetPos[m] = pos;
                            g_mode[m] = POSITION;
                            break;
                        }
                    }
                } else {
                    // Servo adjustment — always by angle, 1° per step
                    uint8_t si = sel - NUM_MOTORS;
                    float   pos = g_servoTarget[si] + d * 1.0f;
                    g_servoTarget[si] = constrain(pos, 0.0f, 180.0f);
                }
            }
            if (btnPress) {
                g_manualEdit = false;   // return to scroll mode
            }
        }

    } else {
        // ---- All other modes — button returns to menu -------------------
        if (btnPress) {
            coastAll();
            g_inMenu = true;
        }
    }

    controlLoop(now);
}
