jmohos/Wiper_Motor_Servo/Software/Wiper_Servo_Motor/src/Display.cpp

#include "Display.h"
#include "AnimComProtocol.h"
#include <Adafruit_ST7735.h>
#include <Adafruit_GFX.h>
#include <SPI.h>

// ---------------------------------------------------------------------------
// Static member definitions
// ---------------------------------------------------------------------------
bool Display::_ready = false;

// ---------------------------------------------------------------------------
// Colours — RGB565
// ---------------------------------------------------------------------------
static constexpr uint16_t C_BG       = 0x0000;  // black background
static constexpr uint16_t C_WHITE    = 0xFFFF;  // primary text
static constexpr uint16_t C_LGRAY    = 0xC618;  // detail text
static constexpr uint16_t C_DGRAY    = 0x39E7;  // dividers / unselected items
static constexpr uint16_t C_HEADER   = 0x000D;  // dark navy — header bar
static constexpr uint16_t C_MANUAL   = 0xFFE0;  // yellow  — MANUAL mode bar
static constexpr uint16_t C_VELOCITY = 0x07E0;  // green   — VELOCITY mode bar
static constexpr uint16_t C_POSITION = 0x07FF;  // cyan    — POSITION mode bar
static constexpr uint16_t C_SERVO    = 0xF81F;  // magenta — servo bar
static constexpr uint16_t C_DISABLED = 0xF800;  // red     — DISABLED state
static constexpr uint16_t C_ANIMCOM  = 0x07FF;  // cyan    — ANIMCOM state

// ---------------------------------------------------------------------------
// Layout constants — 128 × 160 portrait
// ---------------------------------------------------------------------------
static constexpr uint16_t SCR_W = 128;
static constexpr uint16_t SCR_H = 160;

// --- Status screen ---
static constexpr uint16_t Y_HDR         =   0;  static constexpr uint16_t H_HDR       = 16;
static constexpr uint16_t Y_M0          =  16;  static constexpr uint16_t H_MOTOR     = 44;
static constexpr uint16_t Y_DIV0        =  60;  static constexpr uint16_t H_DIV       =  2;
static constexpr uint16_t Y_M1          =  62;
static constexpr uint16_t Y_DIV1        = 106;
static constexpr uint16_t Y_S0_BAR      = 108;  static constexpr uint16_t H_SRV_BAR   = 12;
static constexpr uint16_t Y_S0_VAL      = 120;
static constexpr uint16_t Y_S1_BAR      = 128;
static constexpr uint16_t Y_S1_VAL      = 140;
static constexpr uint16_t Y_STATUS_BAR  = 148;  static constexpr uint16_t H_STATUS_BAR = 12;
// y = 160 — end

// Motor-section offsets (relative to section ybase):
static constexpr uint8_t MO_BAR_H   = 12;   // mode-colour bar
static constexpr uint8_t MO_VAL_Y   = 12;   // scale-2 primary value
static constexpr uint8_t MO_LINE1_Y = 28;   // scale-1 detail line 1
static constexpr uint8_t MO_LINE2_Y = 36;   // scale-1 detail line 2
// H_MOTOR = 44 total (no wasted padding)

// --- Menu screen ---
static constexpr uint16_t MENU_HDR_H  = 16;
static constexpr uint16_t MENU_ITEM_H = 36;   // 4 items × 36 = 144 px → 16+144 = 160
static constexpr uint16_t MENU_ITEM_Y = 16;   // first item starts here

// ---------------------------------------------------------------------------
// TFT instance — hardware SPI0 (SCK=GPIO18, MOSI=GPIO19)
// Canvas — full-screen RAM framebuffer; all drawing targets this, then the
// completed frame is blasted to the TFT in one SPI burst (true double buffer).
// 128×160×2 = 40,960 bytes — fits comfortably in RP2040's 264 KB SRAM.
// ---------------------------------------------------------------------------
static Adafruit_ST7735  tft(&SPI, DISP_CS_PIN, DISP_DC_PIN, DISP_RST_PIN);
static GFXcanvas16      canvas(SCR_W, SCR_H);

// ---------------------------------------------------------------------------
// Private helpers
// ---------------------------------------------------------------------------

static inline void hband(uint16_t y, uint16_t h, uint16_t color) {
    canvas.fillRect(0, y, SCR_W, h, color);
}

// Print text at (x,y) with opaque background so old content is overwritten.
// Scale-1 chars: 6×8 px — pad to 21 chars to cover the 126 px usable width.
// Scale-2 chars: 12×16 px — pad to 10 chars.
void Display::_txtAt(int16_t x, int16_t y, uint8_t sz, uint16_t fg, const char* str) {
    char padded[24];
    snprintf(padded, sizeof(padded), (sz == 1) ? "%-21s" : "%-10s", str);
    canvas.setTextSize(sz);
    canvas.setTextColor(fg, C_BG);
    canvas.setCursor(x, y);
    canvas.print(padded);
}

// Fill a full-width band and print a small label inside it.
void Display::_colorBar(uint16_t y, uint16_t h, uint16_t bg, const char* label) {
    hband(y, h, bg);
    canvas.setTextSize(1);
    canvas.setTextColor(C_BG, bg);
    canvas.setCursor(3, y + (h - 8) / 2);
    canvas.print(label);
}

// ---------------------------------------------------------------------------
// Motor section — 44 px starting at ybase
// ---------------------------------------------------------------------------
void Display::_drawMotorSection(uint8_t m, uint16_t yb, const DisplayState& ds) {
    char buf[22];

    // Mode bar — in MANUAL mode, highlight when cursor is on this motor.
    uint16_t    barCol;
    const char* barLabel;
    switch (ds.mode[m]) {
        case 2:  barCol = C_POSITION; barLabel = m ? "M2 POSITION" : "M1 POSITION"; break;
        case 1:  barCol = C_VELOCITY; barLabel = m ? "M2 VELOCITY" : "M1 VELOCITY"; break;
        default: barCol = C_MANUAL;   barLabel = m ? "M2 MANUAL  " : "M1 MANUAL  "; break;
    }
    // Cursor: selected=white outline bar, edit=bright green bar
    bool mSel  = (ds.manualSel == m);
    bool mEdit = mSel && ds.manualEdit;
    if (mEdit)     barCol = C_VELOCITY;   // green = actively editing
    else if (mSel) barCol = C_WHITE;      // white = cursor here, not editing
    char labelBuf[14];
    snprintf(labelBuf, sizeof(labelBuf), "%s%s", mSel ? ">" : " ", barLabel);
    _colorBar(yb + 0, MO_BAR_H, barCol, labelBuf);

    // Primary value (scale 2) — show OFFLINE alert for encoder-dependent modes.
    bool encFault = ds.encoderOffline[m] && (ds.mode[m] != 0);
    if (encFault) {
        _txtAt(2, yb + MO_VAL_Y, 2, C_DISABLED, "OFFLINE");
    } else {
        switch (ds.mode[m]) {
            case 2:  snprintf(buf, sizeof(buf), "%.1fdeg", ds.measPosAbs[m]);  break;
            case 1:  snprintf(buf, sizeof(buf), "%.1fd/s", ds.measVel[m]);     break;
            default: snprintf(buf, sizeof(buf), "Dty%+d",  (int)ds.duty[m]);   break;
        }
        _txtAt(2, yb + MO_VAL_Y, 2, C_WHITE, buf);
    }

    // Detail lines (scale 1)
    if (encFault) {
        _txtAt(2, yb + MO_LINE1_Y, 1, C_DISABLED, "encoder offline");
        _txtAt(2, yb + MO_LINE2_Y, 1, C_LGRAY,    "");
    } else {
        switch (ds.mode[m]) {
            case 2:  // POSITION
                snprintf(buf, sizeof(buf), "Tgt:%.1f E:%+.1f", ds.targetPos[m], ds.posError[m]);
                _txtAt(2, yb + MO_LINE1_Y, 1, C_LGRAY, buf);
                snprintf(buf, sizeof(buf), "V:%.1fd/s", ds.measVel[m]);
                _txtAt(2, yb + MO_LINE2_Y, 1, C_LGRAY, buf);
                break;
            case 1:  // VELOCITY
                snprintf(buf, sizeof(buf), "Cmd:%.1fd/s", ds.commandedVel[m]);
                _txtAt(2, yb + MO_LINE1_Y, 1, C_LGRAY, buf);
                snprintf(buf, sizeof(buf), "Abs:%.1fdeg", ds.measPosAbs[m]);
                _txtAt(2, yb + MO_LINE2_Y, 1, C_LGRAY, buf);
                break;
            default:  // MANUAL
                snprintf(buf, sizeof(buf), "Abs:%.1fdeg", ds.measPosAbs[m]);
                _txtAt(2, yb + MO_LINE1_Y, 1, C_LGRAY, buf);
                _txtAt(2, yb + MO_LINE2_Y, 1, C_LGRAY, "");
                break;
        }
    }
}

// ---------------------------------------------------------------------------
// Servo row — bar (H_SRV_BAR px) + value line (8 px) starting at ybar
// ---------------------------------------------------------------------------
void Display::_drawServoRow(uint8_t idx, uint16_t ybar, const DisplayState& ds) {
    char buf[22];
    // Cursor highlight: servo cursor index is NUM_MOTORS + idx (2 or 3)
    bool sSel  = (ds.manualSel == (uint8_t)(NUM_MOTORS + idx));
    bool sEdit = sSel && ds.manualEdit;
    uint16_t barCol = sEdit  ? C_VELOCITY :
                      sSel   ? C_WHITE    : C_SERVO;
    char label[12];
    snprintf(label, sizeof(label), "%sS%d SERVO", sSel ? ">" : " ", idx + 1);
    _colorBar(ybar, H_SRV_BAR, barCol, label);
    if (ds.servoActual[idx] != ds.servoTarget[idx]) {
        snprintf(buf, sizeof(buf), "%d->%ddeg", ds.servoActual[idx], ds.servoTarget[idx]);
    } else {
        snprintf(buf, sizeof(buf), "%ddeg", ds.servoActual[idx]);
    }
    _txtAt(2, ybar + H_SRV_BAR, 1, C_WHITE, buf);
}

// ---------------------------------------------------------------------------
// Bottom status bar — mode-coloured 12 px band with contextual info
// ---------------------------------------------------------------------------
void Display::_drawStatusBar(AppState state, const DisplayState& ds) {
    char buf[22];
    uint16_t barCol;

    switch (state) {
        case STATE_DISABLED:
            // EXIT is the only selectable item — always shown as selected.
            hband(Y_STATUS_BAR, H_STATUS_BAR, C_WHITE);
            canvas.setTextSize(1);
            canvas.setTextColor(C_BG, C_WHITE);
            canvas.setCursor(3, Y_STATUS_BAR + (H_STATUS_BAR - 8) / 2);
            canvas.print("> EXIT");
            return;
        case STATE_MANUAL: {
            // Bottom row is the EXIT cursor item.
            bool exitSel  = (ds.manualSel == 4);
            bool exitEdit = exitSel && ds.manualEdit;
            barCol = exitSel ? (exitEdit ? C_VELOCITY : C_WHITE) : C_DGRAY;
            uint16_t fg   = exitSel ? C_BG : C_LGRAY;
            hband(Y_STATUS_BAR, H_STATUS_BAR, barCol);
            canvas.setTextSize(1);
            canvas.setTextColor(fg, barCol);
            canvas.setCursor(3, Y_STATUS_BAR + (H_STATUS_BAR - 8) / 2);
            canvas.print(exitSel ? "> EXIT" : "  EXIT");
            return;   // skip _colorBar at the bottom of this function
        }
        case STATE_ANIMCOM:
            barCol = C_ANIMCOM;
            switch (ds.animState) {
                case ANIMCOM_STATE_RUN_AUTO: snprintf(buf, sizeof(buf), "RS485:P%d@%d%%  BTN:MENU",
                                                     ds.animPattern, ds.animShowIntensity); break;
                case ANIMCOM_STATE_MANUAL:   snprintf(buf, sizeof(buf), "RS485:MANUAL  BTN:MENU"); break;
                default:                    snprintf(buf, sizeof(buf), "RS485:IDLE  BTN:MENU");   break;
            }
            break;
        default:
            barCol = C_DGRAY;
            snprintf(buf, sizeof(buf), "BTN:MENU");
            break;
    }
    _colorBar(Y_STATUS_BAR, H_STATUS_BAR, barCol, buf);
}

// ---------------------------------------------------------------------------
// Public: begin
// ---------------------------------------------------------------------------
void Display::begin() {
    // On arduino-pico (Earle Philhower), pin assignments must be set before
    // SPI.begin().  The Adafruit library calls begin() internally inside
    // initR(), so set pins and call begin() explicitly first.
    SPI.setSCK(DISP_SCK_PIN);
    SPI.setTX(DISP_MOSI_PIN);
    SPI.begin();

    // ST7735S 128×160 — INITR_BLACKTAB is the standard init sequence for
    // the common 1.8" red-PCB module.  Use INITR_GREENTAB for green-tab
    // variants (adds a 2-pixel row/col offset correction automatically).
    tft.initR(INITR_BLACKTAB);
    tft.setSPISpeed(DISP_SPI_FREQ);
    tft.setRotation(0);       // portrait, connector at bottom
    tft.fillScreen(C_BG);

    _ready = true;
}

// ---------------------------------------------------------------------------
// Public: drawMenu
// ---------------------------------------------------------------------------
void Display::drawMenu(uint8_t selectedIdx) {
    if (!_ready) return;

    // Header bar
    hband(0, MENU_HDR_H, C_HEADER);
    canvas.setTextSize(1);
    canvas.setTextColor(C_WHITE, C_HEADER);
    canvas.setCursor(4, (MENU_HDR_H - 8) / 2);
    canvas.print("WIPER MOTOR CTRL");

    // Item definitions: per-item colour and label
    struct Item { uint16_t color; const char* label; };
    static const Item kItems[NUM_APP_STATES] = {
        { C_DISABLED, "DISABLED" },
        { C_VELOCITY, "MANUAL"   },
        { C_ANIMCOM,  "ANIMCOM"  },
        { C_MANUAL,   "CONFIG"   },
    };

    for (uint8_t i = 0; i < NUM_APP_STATES; i++) {
        uint16_t iy  = MENU_ITEM_Y + i * MENU_ITEM_H;
        bool     sel = (i == selectedIdx);
        uint16_t bg  = sel ? kItems[i].color : C_DGRAY;

        hband(iy, MENU_ITEM_H, bg);

        // Selection arrow and label in scale-2 text, vertically centred.
        uint16_t ty = iy + (MENU_ITEM_H - 16) / 2;
        uint16_t fg = sel ? C_BG : C_WHITE;
        canvas.setTextSize(2);
        canvas.setTextColor(fg, bg);

        // Arrow at x=4
        canvas.setCursor(4, ty);
        canvas.print(sel ? ">" : " ");

        // Label at x=22
        canvas.setCursor(22, ty);
        canvas.print(kItems[i].label);
    }

    // Blit completed frame to display in one SPI burst — no partial updates visible.
    tft.drawRGBBitmap(0, 0, canvas.getBuffer(), SCR_W, SCR_H);
}

// ---------------------------------------------------------------------------
// Public: update  (status screen)
// ---------------------------------------------------------------------------
void Display::update(AppState state, const DisplayState& ds) {
    if (!_ready) return;

    // Header bar — mode name + hint
    hband(Y_HDR, H_HDR, C_HEADER);
    canvas.setTextSize(1);
    canvas.setTextColor(C_WHITE, C_HEADER);
    canvas.setCursor(3, Y_HDR + (H_HDR - 8) / 2);
    switch (state) {
        case STATE_DISABLED: canvas.print("DISABLED      <MENU"); break;
        case STATE_MANUAL:   canvas.print("MANUAL        <MENU"); break;
        case STATE_ANIMCOM:  canvas.print("ANIMCOM       <MENU"); break;
        case STATE_CONFIG:   canvas.print("CONFIG        <MENU"); break;
        default:             canvas.print("?             <MENU"); break;
    }

    // Motor sections
    _drawMotorSection(0, Y_M0, ds);
    hband(Y_DIV0, H_DIV, C_DGRAY);
    _drawMotorSection(1, Y_M1, ds);
    hband(Y_DIV1, H_DIV, C_DGRAY);

    // Servo rows
    _drawServoRow(0, Y_S0_BAR, ds);
    _drawServoRow(1, Y_S1_BAR, ds);

    // Bottom status bar
    _drawStatusBar(state, ds);

    // Blit completed frame to display in one SPI burst — no partial updates visible.
    tft.drawRGBBitmap(0, 0, canvas.getBuffer(), SCR_W, SCR_H);
}

// ---------------------------------------------------------------------------
// Config screen — 128 × 160 portrait
//
// Layout:  16 px header + 9 × 16 px items = 160 px exactly.
//   y=  0 – 15  : Header "CONFIG  Btn:edit/OK"
//   y= 16 – 31  : Item 0 — Station ID
//   y= 32 – 47  : Item 1 — M0 Type
//   y= 48 – 63  : Item 2 — M0 Vel Limit
//   y= 64 – 79  : Item 3 — M0 Traverse Vel
//   y= 80 – 95  : Item 4 — M1 Type
//   y= 96 –111  : Item 5 — M1 Vel Limit
//   y=112 –127  : Item 6 — M1 Traverse Vel
//   y=128 –143  : Item 7 — SAVE (saves to flash, returns to menu)
//   y=144 –159  : Item 8 — EXIT (discards unsaved changes, returns to menu)
// ---------------------------------------------------------------------------

static constexpr uint16_t CFG_HDR_H  = 16;
static constexpr uint16_t CFG_ITEM_H = 16;
// 16 + 9×16 = 160 — exactly fills the screen.

static const char* const kMTypeLabels[3] = { "PWM%", "VEL ", "POS " };

void Display::drawConfig(const ConfigDisplayState& cfg) {
    if (!_ready) return;

    // Header
    hband(0, CFG_HDR_H, C_HEADER);
    canvas.setTextSize(1);
    canvas.setTextColor(C_WHITE, C_HEADER);
    canvas.setCursor(3, (CFG_HDR_H - 8) / 2);
    canvas.print("CONFIG  Btn:edit/OK  ");

    static const char* const kLabels[NUM_CFG_ITEMS] = {
        "Station ID",
        "M0 Type   ",
        "M0 VelLim ",
        "M0 TravVel",
        "M1 Type   ",
        "M1 VelLim ",
        "M1 TravVel",
        ">>> SAVE  ",
        ">>> EXIT  ",
    };

    for (uint8_t i = 0; i < NUM_CFG_ITEMS; i++) {
        uint16_t iy  = CFG_HDR_H + i * CFG_ITEM_H;
        bool     sel = (i == cfg.selectedItem);
        bool     ed  = sel && cfg.editMode;

        uint16_t bg = ed  ? C_VELOCITY :   // bright green = actively editing
                      sel ? C_DGRAY    :   // grey = selected, not editing
                            C_BG;          // black = unselected

        hband(iy, CFG_ITEM_H, bg);

        canvas.setTextSize(1);
        canvas.setTextColor(C_WHITE, bg);

        // Selection arrow
        canvas.setCursor(2, iy + (CFG_ITEM_H - 8) / 2);
        canvas.print(sel ? ">" : " ");

        // Label
        canvas.setCursor(10, iy + (CFG_ITEM_H - 8) / 2);
        canvas.print(kLabels[i]);

        // Value (right column at x=76)
        char val[10] = {};
        switch (i) {
            case 0: snprintf(val, sizeof(val), "0x%02X", cfg.nodeId);   break;
            case 1: snprintf(val, sizeof(val), "%s", kMTypeLabels[cfg.mType[0] < 3 ? cfg.mType[0] : 0]); break;
            case 2: snprintf(val, sizeof(val), "%4.0f", cfg.velLimit[0]); break;
            case 3: snprintf(val, sizeof(val), "%4.0f", cfg.travVel[0]);  break;
            case 4: snprintf(val, sizeof(val), "%s", kMTypeLabels[cfg.mType[1] < 3 ? cfg.mType[1] : 0]); break;
            case 5: snprintf(val, sizeof(val), "%4.0f", cfg.velLimit[1]); break;
            case 6: snprintf(val, sizeof(val), "%4.0f", cfg.travVel[1]);  break;
            default: break;  // SAVE row — no value
        }
        canvas.setCursor(76, iy + (CFG_ITEM_H - 8) / 2);
        canvas.print(val);
    }

    tft.drawRGBBitmap(0, 0, canvas.getBuffer(), SCR_W, SCR_H);
}
