jmohos/Wiper_Motor_Servo/(commit log)

2026-03-24 Initial commit — dual-motor wiper servo controller
    Hardware: KiCad schematic/PCB, 3D-printed encoder mount parts.
    Software: PlatformIO/Arduino project for RP2040 (Raspberry Pi Pico)
    - Dual BTS7960 brushless motor drivers with closed-loop PID
    - AS5600 magnetic encoders on separate I2C buses (I2C0/I2C1)
    - Multi-turn absolute position tracking (software accumulation)
    - DMX512 input via RS485 transceiver
    - SPI OLED + rotary encoder local UI
    - Two RC servo PWM outputs (GPIO26/27)
    - NVM settings persistence in flash
    [Encoder_Cap.stl, Encoder_Plate.stl, Magnet_Mount.stl, RFB-0505S.step, Wiper_Servo_Controller.kicad_pcb, Wiper_Servo_Controller.kicad_sch]
2026-03-24 Adding servo ramping and LCD display output.
2026-03-24 Added servo outputs.
    [Wiper_Servo_Controller.kicad_sch]
2026-04-01 Switch from DMX to RS485
    [Wiper_Servo_Controller-B_Cu.gbl, Wiper_Servo_Controller-B_Fab.gbr, Wiper_Servo_Controller-B_Mask.gbs, Wiper_Servo_Controller-B_Paste.gbp, Wiper_Servo_Controller-B_Silkscreen.gbo, Wiper_Servo_Controller-Edge_Cuts.gm1, Wiper_Servo_Controller-F_Cu.gtl, Wiper_Servo_Controller-F_Fab.gbr]
2026-04-07 Fixed compatibility with the animation controller man mode.
    [AnimComSlave.cpp, AnimComSlave.h, Display.cpp, Display.h, Settings.cpp, Settings.h, main.cpp]
2026-04-12 Enhanced console with stream on/off. Added bootload support to prevent needing to use BOOT button. Added meter animation with wiggle.
    [AnimComProtocol.h, AnimComSlave.cpp, AnimComSlave.h, Display.cpp, Display.h, StationAnim.cpp, StationAnim.h, main.cpp]
2026-04-15 Basic robot animation done.
    [Display_Mount.stl, Quad_Controller_Lower_Plate.stl]
